cjlawson02/Rumtime/hardware/cad/refs/dc-inlet-plug.md

# 12 V inlet: 5.5 × 2.1 mm screw-terminal female plug (rear panel)

**Source:** seller listing, bought on AliExpress 2026-06-18 from VooVoo Dropshipping Store ("5pairs DC 12V Female And Male Connectors 5.5x2.1mm"), order ref 8211994997574039. Not yet measured.

## From the listing (unverified)

| Item | Value | Note |
| --- | ---: | --- |
| Barrel | 5.5 mm OD, 2.1 mm pin | Mates the GST60A12-P1J plug. The GST120A12-R7B has a DIN-4 plug and would need a 5.5 × 2.1 male fitted |
| Body | about 41 × 14 mm (1.6" × 0.55") | Listing height "5 in" is a typo |
| Wire entry | Screw terminals, no crimp | |
| Rating | 12 V DC, **2 A max** | Below the 5 A (GST60) and 10 A (GST120) fuses |

## Mounting

- No panel flange. The female plug sits in a printed holder set into the drawer face, socket flush with the outside. The holder clamps the body so pulling the PSU plug doesn't load the screw terminals.
- Builder choice (2026-11-01): use it as the PSU intake despite the 2 A listing. It must pass the heat test in Test 11.7 ([`14-bench-test-protocol.md`](../../../docs/14-bench-test-protocol.md)). If it fails, cut the PSU plug and hardwire the lead into J1 through a strain relief.
