cjlawson02/Rumtime/docs/15-project-timeline.md

# Project Timeline

Living Gantt and procurement log for Rumtime v1. Update after bench sessions, orders, and phase gates.

Reference: [`09-build-plan-and-verification.md`](09-build-plan-and-verification.md), [`14-bench-test-protocol.md`](14-bench-test-protocol.md).

**Last updated:** 2026-11-01 (KF301 + 1×22 in; Oct 25 motherboard batch complete; Oct 29 remainder + PCBs still out).

## Gantt chart

```mermaid
gantt
    title Rumtime v1 — build timeline
    dateFormat YYYY-MM-DD
    axisFormat %b %d

    section Planning
    Docs and v1 decisions           :done, plan, 2026-06-17, 3d
    Phase 0 mini-BOM and bench spec :done, bom, 2026-06-17, 1d
    Bench-rig CI workflow           :done, ci, 2026-06-20, 1d

    section Procurement
    Phase 0 bulk order placed      :done, po, 2026-06-18, 1d
    Phase 0 bulk parts received    :done, recv, 2026-06-27, 1d
    Load cell and HX711 ordered     :done, lc_po, 2026-06-23, 1d
    Load cell and HX711 received    :done, lc_recv, 2026-06-23, 14d
    Pump replacements              :done, pump_returns, 2026-06-27, 22d
    Barb replacement               :active, barb_return, 2026-06-27, 22d
    Load-cell bar measured + FDM   :done, lc_cad, 2026-08-16, 2d
    Cantilever assembled           :active, lc_asm, 2026-08-16, 1d

    section Bench electronics
    Firmware flash and serial       :done, fw, 2026-06-27, 1d
    TB6612 wired                    :done, wire, 2026-06-27, 1d
    HX711 and load cell bar wired   :lc_wire, after lc_recv, 1d
    P1 spin and stop command        :done, p1e, 2026-06-27, 1d
    P2 motor bus wired              :done, p2e, 2026-06-27, 1d

    section Bench liquid Phase 1
    Test 1 electrical baseline      :active, t1, 2026-06-27, 14d
    Test 2 prime and leak           :done, t2, 2026-06-27, 1d
    Test 3 flow calibration         :done, t3, 2026-06-27, 1d
    Test 4 pour repeatability       :active, t4, 2026-06-27, 14d
    Test 5 anti-drip tuning         :done, t5, 2026-06-27, 1d
    Fuse and main power cutoff install    :active, safe, 2026-06-27, 14d
    Test 6 syrup and grenadine      :t6, 2026-07-11, 7d
    Tests 7 to 9 load cell gating   :active, t79, 2026-08-16, 14d
    Test 10 I2C on first module     :t10, after p2fab, 7d
    Phase 0 to 1 pour review        :milestone, crit, p01exit, 2026-08-01, 1d

    section Phase 2 plus
    KiCad 4-pump schematic v1      :done, p2sch, 2026-08-16, 1d
    KiCad 4-pump layout            :done, p2des, 2026-08-16, 70d
    4-pump PCB ordered             :done, p2po, 2026-10-25, 1d
    4-pump module parts ordered    :done, p2parts, 2026-10-25, 1d
    Motherboard Mini560 + Micro-Fit verticals :done, mbparts, 2026-10-25, 1d
    Remaining electronics ordered  :done, mbparts2, 2026-10-29, 1d
    Main-controller PCB ordered    :done, mbpo, 2026-10-29, 1d
    Partial AliExpress receive     :done, ae_recv1, 2026-11-01, 1d
    JST-XH pigtails on all 8 motors :done, jst8, 2026-11-01, 1d
    4-pump PCB fab and assembly    :active, p2fab, after p2po, 21d
    Main-controller fab            :active, mbfab, after mbpo, 21d
    Cartridge and nozzle prototype  :p3, after p2fab, 21d
    8-pump v1 assembly              :p4, after p3, 30d
```

**Legend:** `done` = verified in repo or bench log; `active` = started, not complete; unmarked future bars = planned (dates are estimates until Phase 1 exit).

## Milestones

| Date | Milestone | Evidence |
| --- | --- | --- |
| 2026-06-17 | Project repo and v1 hardware docs | Initial commit |
| 2026-06-17 | Phase 0 decisions locked (KPHM100, TB6612, S3) | `12-phase-0-decisions.md` |
| 2026-06-17 | Bench-rig firmware tree added | `firmware/bench-rig/` |
| 2026-06-18 | Phase 0 bulk parts ordered (mini-BOM) | Operator |
| 2026-06-20 | Bench-rig CI (PlatformIO build) | `.github/workflows/` |
| 2026-06-23 | Load cell bar + HX711 ordered (same shipment)  | Operator |
| 2026-06-27 | Phase 0 bulk parts received (scale kit pending) | Operator |
| 2026-06-27 | Session 01 — TB6612 + P1 bring-up (no scale yet) | `bench-results/2026-06-27-session-01.md` |
| 2026-06-27 | Session 02 — P1+P2 @ 1.75 ml/s, anti-drip 100 ms | `bench-results/2026-06-27-session-02.md` |
| 2026-06-27 | 2× 24 V pumps returned; smooth couplers return **pending** (1.8 mm ID, on hand) | Operator |
| 2026-07-12 | Session 03 — product FW/kiosk pour (open-loop), cancel, Wi‑Fi disconnect stop | `bench-results/2026-07-12-session-03.md` |
| 2026-07-12 | Session 04 — HX711 MCU wired (GPIO 8/9); load cell bar pending | `bench-results/2026-07-12-session-04.md` |
| 2026-07-18 | 8× correct 12 V HB pumps on hand; 2× wrong 24 V pumps returned | Operator |
| 2026-07-19 | Session 05 — four-pump CAD coupons: mount holes pass; walls→2 mm; Ø32/Ø3.3; clamp silicone pending | `bench-results/2026-07-19-session-05.md` |
| 2026-08-16 | Session 06 — load-cell bar measured (75 mm, M4 tapped); bench cleat/pad/pins printing | `bench-results/2026-08-16-session-06.md` |
| 2026-08-16 | Session 07 — cantilever assembled (not measured); 4-pump schematic v1 ERC-clean; PCB silkscreen in progress | `bench-results/2026-08-16-session-07.md` |
| 2026-08-20 | Session 08 — load cell soldered + `scalecal 374.76`; Test 7.1 pass; Tests 7.2–9 deferred | `bench-results/2026-08-20-session-08.md` |
| later | Tests 7.2–9 (glass / vibration / flow-gate) | Deferred 2026-08-20 — **not** a 4-pump PCB gate |
| 2026-10-25 | 4-pump module PCB ordered (OSH Park, 3 boards) | Operator |
| 2026-10-25 | 4-pump module parts ordered (AliExpress equivalents) | Operator |
| 2026-10-25 | Motherboard + module AliExpress batch (Mini560, Micro-Fit V/RA, F1, terminals, passives) | Operator |
| 2026-10-29 | Remaining electronics: 1×8 sockets, Micro-Fit F–F harness, USB-C 6P, SS14, LEDs, 300 Ω | Operator |
| 2026-10-29 | Main-controller PCB ordered for fab | Operator |
| 2026-11-01 | Partial AliExpress receive: Micro-Fit RA 2×3, F1 1812-2A, JST-XH ×2 sets, MCP23017, Mini560 ×2, Micro-Fit vertical 6-pin | Operator |
| 2026-11-01 | More AliExpress: 0805 **2.2 kΩ**, 0805 **100 nF**, 0805 **10 kΩ**, KF301-5.0-2P ×10, plain female **1×22** / **1×6** / **1×4** / **1×8** | Operator |
| 2026-11-01 | JST-XH 2-pin female pigtails spliced/wired on **all 8** KPHM100 motors | Operator |
| 2026-11-01 | Enclosure layout draft accepted (four-slot rear tower, open back, Fire HD 8 pivot mount) | [`08-mechanical-design.md`](08-mechanical-design.md) layout + slot contract; `hardware/cad/src/enclosure_rear_bay_concept.py` |
| TBD | Test 10 (I2C on first module) | Post-fab bring-up — **not** a Gerber gate |
| TBD | Test 11 (enclosure draft checks) → cut wood | Gates "Cartridge and nozzle prototype" |
| TBD | First drink from 8-pump v1 | Phase 4 exit |

## Bench session log (timeline)

| Date | Session | Focus |
| --- | --- | ----- |
| 2026-06-27 | 01 | Firmware, TB6612, P1 dry spin (scale not wired) |
| 2026-06-27 | 02 | Water prime, flow cal, P2, anti-drip, Test 4b partial |
| 2026-07-12 | 03 | Product controller + kiosk: open-loop pour, cancel, disconnect stop (no scale) |
| 2026-07-12 | 04 | HX711 ↔ ESP32 (3.3 V / GND / DT=8 / SCK=9); load cell bar not soldered |
| 2026-07-19 | 05 | Four-pump CAD coupons: mount pattern pass; thin walls + Ø32/Ø3.3; clamp silicone pending |
| 2026-08-16 | 06 | Load-cell bar calipers (75×12.75, holes 5/15/59/69, M4 tap); cleat/pad/pins FDM |
| 2026-08-16 | 07 | Cantilever assembled (not measured); schematic v1 ERC-clean; PCB silkscreen |

## Procurement log

Fill **ordered** and **received** as you go. Sourced from [`13-phase-0-mini-bom.md`](13-phase-0-mini-bom.md).

| Item | Qty ordered | Received | Status | Notes |
| ---- | ---: | --- | --- | ----- |
| KPHM100-HB-B10 pump (12 V) | 10 cumulative | 2026-07-18 | **8 on hand / 2 returned** | The **8 on hand** are correct 12 V HB units. Seller previously shipped **2× 24 V** variants; both were returned. Only **P1+P2** have been bench-validated so far. |
| Pololu TB6612FNG #713 | 4 | 2026-06-27 | OK | **1** on bench (P1+P2); **3** spare — enough for 4-pump bench / Test 10 without reorder |
| ESP32-S3-DevKitC-1 | 1 | 2026-06-27 | OK | N16R8 on bench; 8 MB flash profile |
| Mean Well GST60A12-P1J (12 V 5 A) | 1 | 2026-06-27 | OK | Interim: bench DC supply also in use |
| 3×5 mm FDA silicone tubing | 2 rolls × 5 m | 2026-06-27 | OK | **10 m** total; 3×5 mm class (caliper waived — fit OK on bench) |
| PP barb unions (Quickun B08L5DTRCK class) | 1 set | 2026-06-27 | **Wrong SKU — return pending** | Shipped as **smooth silicone couplers** (slip join, not barbed). **Not yet returned** (post office pending). Operator measured **1.8 mm ID** bore vs **3 mm** line tubing. **Not** a barb union; on outlet (tube in one end, pour from other) narrows orifice vs open 3 mm tube. Food-contact rating not verified. Sessions 01–02 used **open ~3 mm outlet** (no restriction at tip). |
| Spring clamps | 1 set | 2026-06-27 | OK | |
| Inline fuse + main power cutoff | 1 | 2026-06-27 | OK | Not installed yet |
| Estardyn 5 kg load cell bar + HX711 | 1 set | on hand | **OK (cal)** | Session 08: soldered, `scale_ready`, **`scalecal 374.76`**. Test 7.1 pass; 7.2–9 deferred. |
| Graduated cylinder (250 ml) | 1 | 2026-06-27 | OK | In use session 02 |
| Breadboard + jumpers | 1 | 2026-06-27 | OK | |
| MCP23017 breakout | 1 | — | **skip** | Not buying. Test 10 is first assembled module (2026-08-20). |
| 4-pump module parts | 1 set | **2026-11-01** | **OK (parts)** | **On hand:** MCP23017-E/SO; Micro-Fit RA 2×3 (`43045-0600` class); F1 1812-2A; **both** JST-XH 2-pin 5-sets; 0805 **10 kΩ**; 0805 **100 nF**; plain female **1×8** sockets. **Harness:** female JST-XH pigtails wired on **all 8** motors (2026-11-01). Module PCB still out (OSH Park). |
| Motherboard power / bus / sockets | see notes | **2026-11-01** | **OK** | Mini560 **5 V** ×2; Micro-Fit vertical 6-pin; KF301-5.0-2P ×10; 0805 **2.2 kΩ**; plain female **1×22** / **1×6** / **1×4** (DevKit + HX711). |
| Motherboard remainder + harness | see notes | — | **ordered 2026-10-29** | Still out: USB-C **6P** top-mount class; **SS14** Schottky; 3 mm LED kit; **300 Ω** 0805 (LED_STATUS); Micro-Fit **43025** housings + **pre-crimped F–F leads** (DIY home-runs for ~3 modules). |

**Order dates:** Bulk mini-BOM **2026-06-18** (delivered **2026-06-27**). Load cell bar + HX711 **2026-06-23** — soldered and calibrated **2026-08-20** (`scalecal 374.76`). Module + motherboard AliExpress **2026-10-25** and **2026-10-29** — Oct 25 batches **complete 2026-11-01**; still out: Oct 29 harness/USB-C/LED parts, both PCBs.

### Recorded line prices (2026-11-08)

Operator-dictated line prices only. No grand total.

| Source | Item | Qty | Price (USD) |
| --- | ---- | --- | ---: |
| OSH Park | 4-pump module PCB | 3 boards | $13.65 |
| OSH Park | Main-controller PCB | 3 boards | $30.35 |
| AliExpress | 1×8 pin header | 10 pcs (paid total) | $1.86 |
| AliExpress | 0805 300 Ω resistors | — | $1.40 |
| AliExpress | JST 4-pin (XH) | — | $2.60 |
| AliExpress | Green LEDs | — | $1.36 |
| AliExpress | Red LEDs | — | $1.33 |
| AliExpress | Micro-Fit connector housings | — | $5.21 |
| AliExpress | Micro-Fit pre-crimped | — | $9.76 |
| AliExpress | USB-C jacks | — | $1.72 |
| AliExpress | Schottky diodes | — | $1.66 |
| AliExpress | Mini560 | 2 ($1.38 each; paid total after coupon) | $1.97 |
| AliExpress | 2-pin terminal blocks | — | $1.26 |
| AliExpress | Male header pin through-hole Micro-Fit (vertical, not right-angle) | — | $3.31 |
| AliExpress | 1812 2 A fuse | — | $1.14 |
| AliExpress | 0805 2.2 kΩ | — | $0.93 |
| AliExpress | 0805 10 kΩ | — | $1.43 |
| AliExpress | Right-angle Micro-Fit | — | $4.19 |
| AliExpress | 2-pin JST-XH | — | $3.48 |
| AliExpress | MCP23017-E SO | — | $6.33 |
| AliExpress | 0805 100 nF capacitor | — | $0.99 |
| AliExpress | Motors (2026-07-04 order) | 6 (paid total) | $64.98 |
| AliExpress | Motors (2026-06-18 order) | 4 ordered, 2 retained (net after refund; see note) | $23.77 |
| AliExpress | 12 V DC female and male barrel connectors | — | $2.37 |
| AliExpress | On-off switches | 5 pcs | $2.97 |
| AliExpress | Silicon cable, 12 AWG | 2 m | $5.44 |
| AliExpress | Unions | — (**excluded** — full refund; see note) | $4.59 |
| AliExpress | Silicon tubing | 10 m (paid total) | $12.21 |
| AliExpress | M5 tube clamps | — | $1.62 |
| Amazon (2026-06-18) | Inline fuse holders | 4-pack | $7.59 |
| Amazon (2026-06-18) | Mean Well GST60A12 power supply | — | $18.96 |
| AliExpress (2026-06-23) | Estardyn load cell + HX711 | — | $2.16 |
| AliExpress (2026-06-18) | ESP32-S3-DevKitC-1 N16R8 | 1 | $0.95 |
| AliExpress (2026-06-18) | Snvi TB6612FNG | 4 (paid total, incl. shipping) | $9.00 |
| AliExpress | 1×6 female sockets | 10 pcs | $1.33 |
| AliExpress | 1×4 female sockets | 10 pcs | $1.45 |
| AliExpress | 1×22 female sockets | 10 pcs | $2.07 |

**Note (4-motor / Jun 18 line):** Paid **$54.52** for 4; 2 returned (wrong units) with **$30.75** refund. **Net in running total: $23.77** for the 2 retained motors (`$54.52 − $30.75`). Jul 4 six-pack remains **$64.98**.

**Note (1×6 / 1×4 / 1×22 sockets group):** group total **$3.46** (subtotal **$4.85** minus coupon **$0.57** and bonus **$1.20**; ignore / disregard any **$0.38** additional charge).

**Note (unions):** Fully refunded (**$4.59**). **Excluded from running total** (same as canceled LCSC fuse).

Related earlier AliExpress line (Jun 18): SW1 round rocker 5 pcs **$2.97** — see [`hardware/cad/refs/sw1-round-rocker.md`](../hardware/cad/refs/sw1-round-rocker.md). Same figure as the on-off switches row above.

### Open replacements

| Item | Need | Action |
| ---- | ---- | --- |
| Smooth silicone couplers (wrong SKU) | 1 set | **Return pending** — post office not yet; Amazon return for barb-union mis-ship |
| **Barbed** 1/8" PP unions (3×5 mm line) | 1 set | **Deferred** — re-order when plumbing mid-line joins; AliExpress 3 mm PE barbs (Jun 18) were full-refunded |
| M4 × 16–20 mm screws (load cell) | handful | Optional later — bench uses printed taper pins; metal M4 not on hand |

### Still not ordered

| Item | Notes |
| ---- | ----- |
| GST120A12-R7B | Phase 4 / 8-pump PSU — not needed for first module |
| Barbed unions | **Deferred** (see open replacements) |
| Logic-level N-MOSFET (ring light) | **Open (2026-11-08):** verify whether a suitable logic-level N-channel MOSFET is already on hand to switch the hood **12 V ALLCOBLED COB ring** from a free DevKit GPIO (+ external low-side switch). If not on hand, order one (TO-220 or SOT-23). Do **not** reuse `LED_STATUS` / GPIO 38; see [`12-phase-0-decisions.md`](12-phase-0-decisions.md) 2026-11-08 rev-2 note. |

### Future orders (not Phase 0)

| Item | Target phase | Ordered | Received |
| ---- | --- | --- | --- |
| 4-pump KiCad module PCB | 2 | 2026-10-25 (OSH Park, 3) | — |
| 4-pump module parts (+ F1, 1×8) | 2 | 2026-10-25 / 29 (AliExpress) | **2026-11-01** (all stuffing parts on hand; PCB separate) |
| Mini560 + Micro-Fit vertical + KF301 + sockets | 5 (motherboard) | 2026-10-25 (AliExpress) | **2026-11-01** |
| USB-C, SS14, LEDs, 300 Ω, Micro-Fit harness | 5 (motherboard) | 2026-10-29 (AliExpress) | — |
| Main-controller PCB | 5 | 2026-10-29 | — |
| GST120A12-R7B (8-pump PSU) | 4 | — | — |
| Barbed 1/8" PP unions | plumbing | **deferred** | — |
| Second 4-pump module set (beyond 3 PCBs) | 4 | — | — |

## How to update

1. After each bench session — add a row to **Bench session log**; shift or mark Gantt tasks `done` / `active`.
2. When you order or receive parts — fill **Procurement log** dates.
3. When a phase gate passes — add a **Milestones** row and adjust Phase 2+ bar start dates.
4. Optional — open the live canvas: [`rumtime-timeline.canvas.tsx`](/Users/chris2fourlaw/.cursor/projects/Volumes-Workspace-GitHub-Rumtime/canvases/rumtime-timeline.canvas.tsx) (mirrors this file; edit the markdown as source of truth).
