cjlawson02/Rumtime/docs/10-open-questions-and-v2.md

# Open Questions and V2 Ideas

## Open questions — software and firmware

1. HTTP/API contract shape (`/dispense`, `/config`, status transport) — deferred until firmware layers are stable; see [`16-firmware-and-software-architecture.md`](16-firmware-and-software-architecture.md).
2. Offline pour when internet is down but LAN works — deferred; options are kiosk recipe cache or ESP32 favorites snapshot. Kiosk UX locked in [`17-kiosk-ui-plan.md`](17-kiosk-ui-plan.md).
3. LAN authentication (PIN, pairing) — deferred; home-trusted LAN assumed for v1.
4. **OTA firmware updates (ESP32-S3) — Open (2026-11-08):** not implemented; updates are USB-serial only (default board flash profile, no custom partition map). Planned approach (inspired by ESPHome, not a copy of its native TCP protocol): dual-app partition layout (`app0`/`app1` + `otadata`, NVS preserved), Arduino or ESP-IDF OTA write APIs, idle-only authenticated HTTP upload on the existing device HTTP server, plus rollback confirmation and hardening. Effort: a few days for a prototype; about a week or two including rollback and hardening. Do not start until explicitly prioritized. See [`16-firmware-and-software-architecture.md`](16-firmware-and-software-architecture.md).

## Open questions before buying full BOM

1. ~~Which exact pump model gives the best cost/reliability/flow tradeoff?~~ **Resolved for Phase 0:** Kamoer **KPHM100-HBB10** — bench-verify samples. See [`12-phase-0-decisions.md`](12-phase-0-decisions.md).
2. What is the measured pump current under water, syrup, and startup/stall conditions? *(Rated 0.5 A; stall TBD on bench — use [`14-bench-test-protocol.md`](14-bench-test-protocol.md).)*
3. ~~What tubing size is actually compatible with the chosen pump head?~~ **Resolved:** BPT B10, **3 mm ID × 5 mm OD**.
4. ~~Are cheap quick disconnects acceptable, or are barbs/clamps better for v1?~~ **Resolved for Phase 0–1:** barbs + clamps; selective QD later.
5. Does anti-drip reverse work without de-priming the line? *(Bench Tests 5, 4b, 9; flow-gated pour start mitigates under-pour when line fill varies.)*
6. Does the load cell remain stable enough for **flow-gated dispense** with glass plus ice during pump vibration? *(**Deferred 2026-08-20** — Tests 7.6, 9 later; bar cal done. Still gates proven v1 default vs timed fallback when we run them.)*
11. What `flow_threshold` and timeout work across water, syrup, and simultaneous 2-pump pours?
12. Is **8-pump simultaneous** pour into one glass acceptable for splash/overflow? *(Not testable on 2-pump bench — Phase 4.)*
13. Does **GST120** handle 8-pump inrush without sag that breaks calibration? *(Simulate on bench with measured currents.)*
7. ~~What enclosure dimensions are needed after real pump/cartridge measurements?~~ **Layout decided (draft, 2026-11-01):** four-slot rear tower with pump heads out the back, open glass bay, electronics box under slot A, Fire HD 8 pivot mount. Draft size 284 × 266 × 409 mm. Wood dimensions stay open until the cartridge slide-in and nozzle-ring checks in [`08-mechanical-design.md`](08-mechanical-design.md) pass.
8. How much residue remains after syrup/grenadine/citrus cleaning tests?
9. ~~Is 8 pumps enough for the desired drink menu, or should the enclosure start with 12 physical nozzle positions?~~ **Resolved:** Start with **8 installed pumps**; design enclosure and electronics for **16 pumps max** (four 4-pump module slots). MCP23017 addressing allows more; 16 remains the mechanical/power ceiling. Pre-plan physical space for 16 inlet clips and nozzles; populate only 8 at first build.
10. ~~How should pump/bottle labels be handled so setup is obvious?~~ **Resolved:** **Dual labels** — label on each **rear inlet-comb clip** (no inlet panel since the 2026-11-01 open-back layout); matching label on each **bottle stopper** where the pickup tube enters. Tube color optional later.

## V2 ideas

Do not implement these until v1 works.

### Mini fridge integration

Possible goal:

- Keep fresh juices chilled while connected.

Concerns:

- Safe tube pass-through.
- Condensation.
- Cleaning.
- Bottle organization.
- Fridge drilling risk.

Recommended approach:

- Avoid drilling unless safe path is known.
- Use existing drain/gasket/pass-through if possible.
- Treat fridge integration as a separate design project.

### Carbonated mixer support

Possible goal:

- Pump or dispense soda/tonic/cola automatically.

Concerns:

- Foam.
- Loss of carbonation.
- Cleaning sticky soda lines.
- Need for chilled storage.
- Different flow behavior than still liquids.

Recommended approach:

- Keep manual top-off in v1.
- Later test one dedicated carbonated line before expanding.

### Bottle-level sensing

Possible goal:

- Detect actual bottle contents instead of estimating inventory.

Options:

- Bottle scales.
- Float/level sensors.
- Vision/manual barcode workflows.
- More careful inventory reconciliation using glass load-cell data.

V1 decision: use software-estimated inventory.

### More accurate closed-loop pouring

Possible goal:

- Sequentially pour each ingredient until target mass is reached.

Concerns:

- Slower.
- Needs density assumptions or per-ingredient density.
- Needs stable load-cell readings during pump vibration.

Recommended path:

1. Use load cell for calibration and **flow-gated timer start** (v1).
2. Use load cell for final sanity check.
3. Add sequential scale-assisted **mass stop** per ingredient only if timed + flow-gate is not good enough.

### Better module network

Possible goal:

- Robust long cable runs and smart modules.

Options:

- CAN bus.
- RS-485.
- Small MCU per module.

V1 decision: I2C is acceptable for short runs under about 3 ft.

### Premium fittings

Possible goal:

- Cleaner ingredient swaps and less mess.

Options:

- Valved CPC/Colder-style quick disconnects.
- Panel-mounted bulkhead quick disconnects.
- Labeled bottle harnesses.

V1 decision: use these selectively because cost multiplies quickly across 8-12 lines.

## Known risks

| Risk | Mitigation |
| --- | --- |
| Cheap pumps vary in flow rate | Calibrate each pump and keep spares. |
| Tubing wears and flow drifts | Treat tubing as consumable; recalibrate periodically. |
| Syrup dries in nozzles | Use warm-water flush and removable nozzle plate. |
| Citrus/juice sanitation issues | Use session-only handling and clean after use. |
| I2C noise with motors | Keep cables short, use proper grounding, add decoupling, lower I2C speed. |
| Pump startup current exceeds driver | Measure current before final PCB; choose driver accordingly. |
| Liquid leaks into electronics | Separate wet/dry compartments; leak test with water. |
| Reverse pump de-primes line | Tune anti-drip; **flow-gated dispense** for recipe pours. |
| Variable line fill breaks timed pour  | Flow-gate on load cell; drip-tray prime stays timed + visual. |
| Bench GPIO ≠ production I2C path | First module PCB is Test 10 (2026-08-20); accept a spin. |
| 8-pump simultaneous untested on bench | Phase 4 recipe simulation; accept incremental risk at PCB fab. |
| Inventory estimate drifts | Use low-volume reserve and manual refill confirmations. |
| Project overcomplicates | Follow AGENTS.md: simplicity first and goal-driven verification. |
