cjlawson02/Rumtime/docs/01-decisions.md

# Captured Design Decisions

This file is the source of truth for current hardware decisions.

## Project identity

| Topic | Decision |
| --- | --- |
| Project name | Rumtime. |
| Short description | A modular cocktail execution engine. |
| Tagline | Compile recipes. Execute cocktails. |
| Repo name | `rumtime`. |
| Naming style | Software-engineer humor is encouraged in docs and module names when it improves clarity, but hardware docs should stay precise. |

Rationale: Rumtime is short, memorable, software-themed, and still clearly connected to drinks. It supports playful terminology without forcing unclear puns into safety-critical hardware documentation.

## Pump count

| Topic | Decision |
| --- | --- |
| V1 pump count | Build for **8 installed pumps**.  |
| Acceptable starting range | 6-8 pumps. |
| Expansion target | 10-12 pumps in near term. |
| **Design limit** | **16 pumps** (4× 4-pump modules). |
| Expansion unit | 4-pump module. |

Rationale: 8 pumps supports useful cocktails without making the first build too large. Designing around 4-pump modules allows expansion without changing controller architecture. **16 pumps is the v1 mechanical/power ceiling** (four module slots). I2C addressing is not the limiter (MCP23017 has eight addresses). Beyond 16 would still need enclosure, PSU, and nozzle-cluster work — not a bus mux.

## Pump strategy

| Topic | Decision |
| --- | --- |
| Pump type | Peristaltic pump. |
| Pump assignment | One pump per ingredient. |
| Reverse pumping | Required if reasonably affordable. |
| Solenoids | Avoid for v1. |
| Shared manifold | Avoid. |
| Phase 0 model | **Kamoer KPHM100-HB-B10** (12 V brushed, B10 3×5 mm tubing). |
| Phase 0 qty | 3 pumps (2 rig + 1 spare). Bench-verify before full BOM. |

Rationale: One pump per ingredient avoids solenoid complexity, cross-contamination, shared-path cleaning, and priming problems. Reversible pumps support anti-drip behavior, draining, and cleaning. KPHM100-HBB10 matches flow, cost, tubing, and TB6612 current targets; see [`12-phase-0-decisions.md`](12-phase-0-decisions.md).

## Measurement strategy

| Topic | Decision |
| --- | --- |
| Primary measurement | Timed dispensing based on calibrated `ml_per_second`. |
| Pour timing | **Flow-gated start** when glass on load cell; timed-from-motor-on fallback on scale fault. |
| Priming requirement | Session prime over drip tray; recipe pours tolerate variable line fill via flow-gating. |
| Flow sensors | Avoid inline flow meters in v1. |
| Load cell | **Required** (5 kg + HX711 under glass). |
| Accuracy target | Good enough, not laboratory precise. |
| Deferred | Per-ingredient closed-loop mass stop during simultaneous 8-pump pours. |

Rationale: Timed dispensing is simple and cheap. Variable line fill after anti-drip makes motor-on timers wrong; flow-gating uses the load cell already required for glass/ice detection. Vibration/flow-gate proof is Test 9 — **deferred 2026-08-20** after bar cal (session 08); not cancelled.

## Glass and dispense position

| Topic | Decision |
| --- | --- |
| Glass location | One fixed dispense location. |
| Ice before pour | Yes, user may place ice in glass first. |
| Glass detection | **Required** — load cell under glass platform. |
| Recommended sensor | Load cell serves glass, ice tare, flow-gate, sanity checks. |

## Ingredients

| Ingredient type | Decision |
| --- | --- |
| Spirits | Support. |
| Liqueurs | Support. |
| Simple syrup | Support; flush after session. |
| Grenadine | Support; flush after session. |
| Fresh citrus, no pulp | Session-only; flush after use. |
| Non-pulpy juices | Support as session-only or refrigerated later. |
| Pulpy juices | Skip in v1. |
| Cream/coconut/purées  | Skip in v1. |
| Carbonated mixers | Manual top-off in v1. |

Rationale: Sugary, acidic, and fresh ingredients are manageable if flushed. Pulp and thick dairy/coconut-style ingredients increase clogging and sanitation risk.

## Carbonation

| Topic | Decision |
| --- | --- |
| Pump carbonated mixers | Not in v1. |
| UI behavior | Recipe can say "top with soda/tonic/cola/etc." |
| Possible v2 | Dedicated chilled/carbonated line can be explored later. |

Rationale: Carbonated liquids foam, lose carbonation, and complicate cleaning. Manual top-off gives most of the value with little complexity.

## Bottles and storage

| Topic | Decision |
| --- | --- |
| Bottle location | External to machine. |
| Bottle size | Flexible; support common 750 ml and 1 L bottles via configuration. |
| Pickup style | **Bottle stoppers** with labeled pickup tubes (not bare dropped-in tubes for v1). |
| Bottle caps/adapters | **Labeled stoppers** per bottle; match machine inlet labels. |
| Fresh juices | Connect only during use unless fridge integration is designed later. |
| Mini fridge | Defer. Do not drill/plumb in v1. |

## Cleaning

| Topic | Decision |
| --- | --- |
| Cleaning effort | Moderate is acceptable. |
| Rinse/flush | Required. |
| Sanitizer | Star San or similar session sanitizer may be used. |
| Permanent sanitizer tank | Not recommended in v1. |
| Tubing | Replaceable consumable. |
| Quick disconnects | Preferred where budget allows. |
| Session-only ingredients | Acceptable. |

## Modular hardware

| Topic | Decision |
| --- | --- |
| Module style | 4-pump expansion boards. |
| Module cases | 3D printed clean cartridges/cases preferred. |
| Distance | Under 3 ft from main controller. |
| Hot-swap | Mechanically swappable, but not powered hot-swap. |
| Connectors | Cheap/easy is acceptable if rigid and reliable. |
| Design style | Cheap and practical, visually clean. |

## Electronics

| Topic | Decision |
| --- | --- |
| Main controller | ESP32, recommended ESP32-S3. |
| Network | Wi-Fi only. |
| Pump voltage | 12 V recommended by default. |
| Pump control | On/off + reverse via I2C GPIO expander; TB6612 PWM strapped high. Speed PWM deferred. |
| I/O expander | **MCP23017-E/SO** per 4-pump module (backup: TCA9539PWR). PCA9685 rejected. |
| Physical controls | Bare minimum. |
| Safety cutoff | Include **main power** cutoff/emergency stop (no separate pump-bus switch). |
| Custom PCB | Expected and acceptable. |
| PCB toolchain | **KiCad 10** (`kicad-cli`) for 4-pump module and future boards. |
| Phase 0 electronics | TB6612FNG breakout + ESP32-S3-DevKitC-1 on breadboard. Bench carrier is Pololu #713. |
| Module driver | AliExpress **SparkFun-pinout** TB6612 clone (item `3256807799494692`), two per 4-pump module. Rows **15.25 mm**, body **21 × 18 mm**. Pololu #713 stays on the bench. |

## Mechanical design

| Topic | Decision |
| --- | --- |
| Appearance | More finished than a raw maker prototype. |
| CAD | **Onshape** for mechanical models; export STEP/STL for print and bench fixtures.  |
| Fabrication | **FDM 3D printer** on hand; woodworking preferred for visible enclosure. |
| Footprint | No hard limit, excluding bottles. |
| Portability | Not required. |
| Bottle visibility | Bottles separate from machine. |
| Labeling | Label on each **rear inlet-comb clip**; matching label on **bottle stopper**. |
| Drip tray | Required. |
| Nozzle style | Individual clustered nozzles; removable funnel acceptable if easy to clean. |

## Budget

| Topic | Decision |
| --- | --- |
| V1 budget target | About $500 max, excluding ingredients. |
| Pump quality | Willing to pay more for reliability if value is clear. |
| Sourcing | Check McMaster for cheap/appropriate food-contact tubing/fittings, but avoid overbuying premium industrial parts. |
| Priority | Best bang for buck. |

## Software stack

| Topic | Decision |
| --- | --- |
| Kiosk UI | Static **React** PWA on **Cloudflare Pages** — see [`17-kiosk-ui-plan.md`](17-kiosk-ui-plan.md). |
| Kiosk frontend | **React 18 + Vite + Tailwind v4 + shadcn** (`base-nova` / Base UI). Production app in [`ui/kiosk/`](../ui/kiosk/). |
| Kiosk device | **Kindle Fire** (Fully Kiosk browser). |
| Real-time control  | **ESP32-S3** product firmware on LAN. |
| Kiosk ↔ ESP32 link | **Wi-Fi HTTP** (JSON). BLE deferred. |
| Wi-Fi (v1) | **Station mode** on home LAN only; credentials via **serial** until soft-AP provisioning. |
| Device discovery | **mDNS** (e.g. `rumtime.local`); DHCP reservation fallback. |
| Pour path | Kiosk → ESP32 directly; **not** through Cloudflare. |
| Kiosk UX | Locked in [`17-kiosk-ui-plan.md`](17-kiosk-ui-plan.md) (menu grid, PIN, bottle bay, pour tuning, session confirm, pour anyway). |
| Recipe content | **Bundled JSON** in kiosk repo for v1 (`src/data/recipes.json`); Cloud KV optional later. Recipes use **ingredient IDs**, not pump numbers. |
| Ingredient IDs | **Opaque strings on ESP32** (binding + dispense lookup). Names/categories/recipes are **kiosk-only**. |
| Pump ↔ ingredient  | **ESP32 NVS** (machine owns what is plumbed). |
| Inventory | **ESP32 authoritative**; subtract on dispense; persists in NVS. |
| Offline operation  | **Bundled recipes + PWA cache** (v1); KV sync optional later. |
| API contract | **Implemented** — firmware exposes kiosk `DeviceStatus` shape per [`18-kiosk-device-api.md`](18-kiosk-device-api.md). |

Rationale: Physical reality (bindings, calibration, inventory) must survive reboot and match plumbed lines. Creative content (recipes) can update in the cloud without reflashing. LAN HTTP matches a browser kiosk and keeps dispense latency off the public internet.

## Firmware architecture

| Topic | Decision |
| --- | --- |
| Framework | **PlatformIO + Arduino** on ESP32-S3 (continue from bench-rig). |
| Runtime model | Explicit FreeRTOS — `ControlTask` + command queue + status snapshot. |
| Control pattern | Periodic **ControlTask** tick + thin **sequence runner** (FRC-inspired, not WPILib). |
| WPILib on ESP32 | No — port the pattern only. |
| Blocking dispense | Not in product firmware — bench rig blocking model is bring-up only. |
| Control period | **5 ms default** (1–10 ms); HX711 non-blocking FSM inside `ScalePlatform`. |
| Concurrency | **0 mutexes on motion path**; queue + snapshot at HTTP boundary. |
| Software mode enum | **Not required v1** — main power cutoff is hardware disable. |
| Manual pours | **Always available in software**; no rear-panel test jumper. |
| Job concurrency | One coordinator job; command queue depth 1; **409 busy** on duplicate dispense. |
| Pump exclusivity | Coordinator policy; `PumpChannel` refuses overlap via bus policy. |
| Pump safety (hardware) | **Main power cutoff** + TB6612 **STBY**; safe GPIO at boot. **No separate pump-bus switch. No bus MOSFET v1.** |
| Pump safety (software) | **Distributed** in pumps, scale, coordinator, steps — no central safety pipeline. |
| JSON on device | **ArduinoJson v7** (`WebServer` on Core 0). |

Full layer diagram and migration notes: [`16-firmware-and-software-architecture.md`](16-firmware-and-software-architecture.md).
