cjlawson02/Rumtime/docs/09-build-plan-and-verification.md

# Build Plan and Verification

This plan follows goal-driven execution: every step has a verification check.

**Bench progress (2026-08-20):** [session 08](bench-results/2026-08-20-session-08.md) — load cell **soldered and calibrated** (`scalecal 374.76`; Test 7.1 pass). Remaining Tests **7.2–7.6** / **9** **deferred** (operator). [Session 07](bench-results/2026-08-16-session-07.md) — cantilever printed/assembled. [Session 06](bench-results/2026-08-16-session-06.md) — bar **measured 75 × 12.75 mm**, holes **5 / 15 / 59 / 69**, **M4 tapped**. [Session 05](bench-results/2026-07-19-session-05.md) — four-pump CAD coupons: mount hole pattern **pass**; walls → **2 mm**; clearance **Ø32 / Ø3.3**; **clamp silicone snap still pending**. Session 03: product controller + kiosk pour / cancel / disconnect. Liquid cal: [session 02](bench-results/2026-06-27-session-02.md) — P1+P2 @ 1.75 ml/s; dual **~0.4 A**; anti-drip 100 ms; Test 4b P2 50→~45 ml.

## Phase 0: Confirm critical parts

1. Select candidate pump.
   - Verify: pump is reversible, 12 V, affordable, and physically measurable.
2. Select tubing and fitting size.
   - Verify: tubing fits pump and fittings without leaks or kinks.
3. Select motor driver.
   - Verify: measured pump current is within driver limits with margin. _(P1: I_run ~0.2 A dry/wet; I_stall_dry 0.9 A, I_stall_wet ~0.33 A — TB6612 OK.)_
4. Select power supply strategy.
   - Verify: supply can run expected simultaneous pumps with margin.

Exit criteria:

- One pump can move water forward and backward under controller or bench control. _(P1 pass — prime, cal, timed dispense.)_
- Tubing/fittings are physically compatible. _(3×5 mm tubing fits KPHM100 B10; caliper waived; barb-union order mis-shipped as 1.8 mm ID smooth couplers — return pending; barbed unions still to re-order.)_
- Pump current is known well enough for driver selection. _(P1 dry + wet documented.)_

## Phase 1: 2-4 pump liquid prototype

Build a temporary rig with 2-4 pumps.

1. Wire pumps to driver breakout or temporary PCB.
   - Verify: each pump runs forward, reverse, and stops reliably. _(P1 + P2 pass.)_
2. Prime lines from bottles/jars.
   - Verify: each line primes without leaks or collapsing tubing. _(P1 + P2 pass.)_
3. Dispense by time.
   - Verify: 15 ml, 30 ml, and 60 ml targets within tolerance after calibration. _(50 ml: P1 ~48, P2 ~50; 15/60 ml open.)_
   - Verify: 15 ml, 30 ml, and 60 ml test pours are repeatable enough.
4. Test anti-drip reverse.
   - Verify: nozzle drip is reduced without losing prime.
5. Test syrup and grenadine.
   - Verify: pump can dispense and flush them without obvious clogging.
6. Test warm-water flush.
   - Verify: visible residue clears from lines/nozzles.
7. Test load cell and flow-gating (v1 pour default; **not** a 4-pump PCB gate).
   - Verify: detects glass, glass plus ice, flow-gated vs timed pour (Tests 7–9).
8. Validate I2C pump path on the **first assembled module** (Test 10).
   - Verify: MCP23017 on the PCB drives pumps; bus stable under motor load. Not a pre-fab breakout.

Exit criteria (pour path; parallel with module schematic):

- At least two pumps pass repeatability tests.
- Syrup/grenadine can be flushed acceptably.
- Anti-drip reverse has a workable setting; Test 4b trend documented.
- Load cell Tests 7–9 pass or flow-gate fallback documented.
- No critical issue requires changing the architecture.

## Phase 2: First 4-pump module PCB

**Schematic v1:** ERC-clean (`hardware/kicad/scripts/check.sh`). HX711 is on the controller, not this board. Stall current already supports TB6612.

**Layout:** in progress (silkscreen / placement). **Fab prerequisite:** DRC + schematic safe-off (Test 10.4). I2C hardware bring-up is Test 10 on first article.

Design and fabricate one 4-pump module PCB.

1. Create schematic.
   - Verify: ERC passes and safe default pump-off behavior is reviewed. _(v1 ERC 0 — 2026-08-16.)_
2. Create layout.
   - Verify: DRC passes and motor current paths are sized appropriately. _(Silkscreen/placement in progress.)_
3. Confirm connectors.
   - Verify: connector pinouts match wiring harness plan.
4. Confirm mounting.
   - Verify: board holes align with a printed/measured cartridge mockup.
5. Assemble one board.
   - Verify: no shorts; logic power and 12 V rails test correctly.
6. Test with one pump.
   - Verify: forward/reverse/stop works.
7. Test with four pumps.
   - Verify: all channels work and simultaneous operation does not brown out/reset logic.

Exit criteria:

- One 4-pump module runs four pumps reliably.
- Module address selection works.
- Module can be physically mounted in a cartridge.

## Phase 3: Mechanical cartridge and nozzle prototype

1. Design 4-pump cartridge.
   - Verify: pumps mount securely and tubing can be serviced.
2. Design nozzle plate.
   - Verify: all outputs aim into the glass and plate is removable.
3. Design drip tray area.
   - Verify: drips fall into removable tray, not electronics.
4. Design tube inlet strain relief.
   - Verify: bottle tubes cannot tug directly on pump fittings.

Exit criteria:

- One cartridge can be installed/removed.
- Tubing can be routed without kinks.
- Nozzle plate and drip tray are cleanable.

## Phase 4: 8-pump v1 assembly

1. Build two 4-pump modules.
   - Verify: each module works independently.
2. Install modules into enclosure.
   - Verify: wet side and electronics are physically separated.
3. Connect 8 liquid paths.
   - Verify: no leaks during priming and flush.
4. Run full calibration.
   - Verify: every pump has stored ml/sec and passes target pour tests.
5. Run recipe simulation with water.
   - Verify: multiple pumps dispense into glass without missing target badly.
6. Run real ingredient session.
   - Verify: drinks are acceptable and cleanup is moderate.

Exit criteria:

- Machine can make a useful set of drinks with 8 ingredients.
- Cleaning workflow is acceptable enough to repeat.
- Inventory tracking can warn before low bottles.

## Phase 5: 12-pump expansion readiness

1. Install or mock third module slot.
   - Verify: physical space, power connector, and I2C address path exist.
2. Connect third module electrically without pumps.
   - Verify: system can detect/address the module.
3. Add pumps 9-12 later.
   - Verify: power supply and wiring can handle additional load.

Exit criteria:

- Expansion to 12 pumps does not require redesigning the enclosure, controller, or power distribution.

## Calibration test matrix

For each pump:

| Test | Target | Pass condition |
| --- | ---: | --- |
| Small pour | 15 ml | Good-enough repeatability. |
| Standard pour | 30 ml | Good-enough repeatability. |
| Large pour | 60 ml | Good-enough repeatability. |
| Anti-drip | Per pump | No excessive dripping; Test 4b without re-prime documented. |
| Flow-gate | Per recipe | Gated vs timed error on de-primed line (Test 9). |
| Flush | Per pump | No visible residue after cleaning cycle. |
| Reverse | Per pump | Pump reverses without leaks or tube collapse. |

Define numeric tolerances after initial prototype results. Do not over-optimize before measuring real pump behavior.

## Cleaning verification

After a real ingredient session:

1. Flush syrup line.
   - Verify: outlet runs clear and is not sticky at nozzle.
2. Flush grenadine line.
   - Verify: color mostly clears and no visible residue remains.
3. Flush citrus/juice line.
   - Verify: no visible residue or pulp remains.
4. Sanitize per label.
   - Verify: contact time and drain/purge steps are completed.
5. Inspect next day.
   - Verify: no obvious odor, residue, or sticky nozzle.

## Safety verification

Before using with ingredients:

1. Activate **main power** cutoff during pump operation.
   - Verify: pumps stop.
2. Reset ESP32 during operation.
   - Verify: pumps stop or remain off.
3. Disconnect/reconnect logic with pump power off.
   - Verify: no unexpected pump activation after reconnect.
4. Simulate no glass (load cell required).
   - Verify: dispensing is blocked or warning is shown.
5. Flow-gated pour with de-primed line.
   - Verify: gated pour within tolerance or fallback documented.
6. Leak test with water.
   - Verify: leaks do not reach electronics.

## Do not skip

- Pump current measurement.
- Tubing/fitting compatibility test.
- Syrup/grenadine cleaning test.
- Anti-drip reverse tuning.
- Load cell flow-gate validation (or documented fallback) — v1 pour default, not a module PCB gate.
- MCP23017 I2C bring-up on the first module PCB (Test 10; not a pre-fab breakout).
- Leak test with water before alcohol/sugar.
- Hardware **main power** cutoff.
