cjlawson02/Rumtime/docs/06-flow-calibration-and-inventory.md

# Flow Calibration and Inventory

This file describes measurement behavior. It is not a software implementation spec.

## Measurement decision

V1 uses **timed dispensing** based on per-pump calibration (`ml_per_second`), with a **load cell under the glass** for guardrails and **flow-gated pour start** when a glass is present.

Inline flow meters are intentionally skipped in v1 because they add cost, cleaning burden, extra wet parts, and possible problems with syrup, bubbles, and pulsed peristaltic flow.

## Accuracy target

The selected target is **good enough** cocktail accuracy, not laboratory accuracy.

A practical v1 goal:

- Repeat common pours within roughly 5-10 ml during normal timed operation.
- Improve calibration or add scale-assisted sequential pouring later if this is not acceptable.

## Calibration model

Each pump/ingredient gets a calibrated flow rate:

```text
ml_per_second = measured_output_ml / run_time_seconds
```

Use that value for dispensing:

```text
run_time_seconds = target_ml / ml_per_second
```

Calibration should be per pump and preferably per ingredient type, because syrup and spirits may flow differently.

## Basic calibration procedure

Manual measuring cup method:

1. Put pickup tube in ingredient or water.
2. Prime line until liquid reaches nozzle.
3. Run pump for a fixed duration, such as 20-30 seconds.
4. Measure output volume in a graduated cylinder or measuring cup.
5. Compute and store ml/sec.
6. Repeat once or twice and average if desired.

Load-cell method:

1. Put a cup on the load-cell platform.
2. Tare the scale.
3. Prime the line.
4. Run pump for a fixed duration.
5. Measure mass increase.
6. Convert mass to approximate ml.
7. Store ml/sec.

For many cocktail ingredients, using 1 g approximately equal to 1 ml is good enough for calibration. If better accuracy is needed, store density per ingredient later.

## Priming state

Timed dispensing from motor-on assumes the line is already full. In practice, fill level is **variable**: dry line, partially wet after anti-drip reverse, or full with a dry nozzle tip. Fixed-time “prime until nozzle wet” cannot know how much liquid is in the line without a sensor.

Track per pump:

```text
pump_id
primed true/false
last_primed_at
last_cleaned_at
```

Possible behavior:

- After cleaning or tube replacement, mark line unprimed.
- After a successful prime cycle (timed over drip tray, or flow detected at glass), mark line primed.
- Do not run normal recipes with an unprimed line unless the user confirms.
- **Flow-gated dispense** (below) reduces dependence on `primed` for recipe pours into a glass on the scale.

## Anti-drip reverse

After each pour, reverse briefly to reduce nozzle drip.

Track per pump:

```text
anti_drip_reverse_ms
```

Start with a conservative value and tune per liquid.

Too little reverse: dripping.
Too much reverse: line partially de-primes and next pour is low.

## Simultaneous versus sequential dispensing

### Normal mode: simultaneous timed pouring

Pros:

- Faster.
- Good for parties.
- Good enough when pumps are calibrated.

Cons:

- Scale cannot tell which ingredient under-poured.
- Total final mass only gives a sanity check.

### Precision mode: sequential scale-assisted pouring

Pros:

- More accurate.
- Can stop each ingredient based on weight increase.
- Easier to detect a problem with a specific line.

Cons:

- Slower.
- More software complexity.
- Requires stable glass platform and tare.

V1 recommendation:

- **Default:** timed simultaneous pours with **flow-gated timer start** when glass is on the load cell.
- **Fallback:** timed-from-motor-on if scale fault or no glass detected.
- **Defer:** fully closed-loop sequential pouring (stop each ingredient by target mass).

## Flow-gated simultaneous dispense

When a glass is on the platform (tared after ice if needed), recipe pours should **not** start ml timers at motor-on. Instead:

```text
1. Start recipe pumps forward (simultaneous mode).
2. Wait for d(weight)/dt > flow_threshold for N consecutive samples (global, one scale).
3. Start per-pump ml timers from that moment.
4. Run each pump for target_ml / ml_per_second.
5. Apply per-pump anti_drip_reverse_ms.
6. Compare total mass increase to expected; warn on large mismatch.
```

**Pre-gate timeout:** if no flow within `flow_detect_timeout_ms`, abort, mark suspect/unprimed, alert user.

**Limits (important):**

- One scale → **one global** flow-onset signal, not per-pump. If P1 is primed and P2 is dry, timers start when the first stream hits the glass; P2 may still under-pour until its line fills. Flow-gating fixes the common case (similar line state after anti-drip); it does not replace per-line priming for asymmetric failures.
- Requires mechanical isolation of the glass platform from pump vibration — see [`08-mechanical-design.md`](08-mechanical-design.md).
- Bench must validate thresholds before locking as v1 default — see Test 9 in [`14-bench-test-protocol.md`](14-bench-test-protocol.md). If vibration blocks reliable detection, fall back to timed dispense + post-pour sanity check; keep the load cell for glass/tare/no-flow.

Drip-tray priming (no glass) remains **timed + visual** “nozzle wet.”

## Load cell uses

The load cell is **required for v1** (HX711 + 5 kg cell under glass platform).

| Behavior | v1?  | Description |
| --- | ---- | --- |
| Glass present | Yes  | Block dispense if weight below threshold. |
| Ice handling | Yes  | Tare after user places glass plus ice. |
| Flow-gated pour start | Yes* | Start ml timers when liquid hits glass (*bench-gated). |
| Calibration | Yes  | Measure dispensed mass during calibration. |
| Pre-gate no-flow abort | Yes  | Pump runs; no flow within timeout → error. |
| Final sanity check | Yes  | Compare expected drink mass to measured increase. |
| Spill/overflow detection | Yes  | Unexpected weight changes can stop operation. |
| Per-ingredient mass stop | No | Deferred — sequential closed-loop (v2 if needed). |

## No-flow detection

**During pour (pre-gate):**

```text
if pumps_running and elapsed > flow_detect_timeout_ms and scale_delta_is_too_small:
    stop operation
    mark pump(s) as suspect/unprimed
    alert user
```

**After pour (sanity check):**

```text
if expected_mass_increase - measured_increase > sanity_threshold:
    warn user (cannot identify which pump in simultaneous mode)
```

Single-pump calibration or prime can attribute no-flow to one line. During simultaneous pours, pre-gate and sanity checks detect **aggregate** failure only.

## Bottle inventory tracking

Software-only tracking is acceptable. **ESP32 NVS is authoritative** for `remaining_ml` and related fields; the kiosk reads machine state for display. Cloud KV may mirror for analytics later but must not be the pour-time source of truth.

Pump ↔ ingredient bindings also live on the ESP32 (not in recipe documents). See [`16-firmware-and-software-architecture.md`](16-firmware-and-software-architecture.md).

Suggested fields:

```text
ingredient_name
pump_id
bottle_size_ml
remaining_ml
low_warning_ml
ml_per_second
primed
last_primed_at
last_cleaned_at
last_refilled_at
```

When a recipe is made:

```text
remaining_ml -= target_dispense_ml
```

When a bottle is changed/refilled:

```text
remaining_ml = configured_bottle_size_ml
primed = false or user_confirmed
```

## Inventory reserve

Do not assume the machine can extract every ml from a bottle.

Use a configurable dead-volume reserve:

```text
usable_volume_ml = bottle_size_ml - reserve_ml
```

Starting suggestions:

| Bottle size | Reserve warning |
| ---: | ---: |
| 375 ml | 40-60 ml |
| 750 ml | 75-100 ml |
| 1 L | 100-125 ml |

This accounts for pickup tube geometry, bottle shape, and priming uncertainty.

## Cleaning and inventory

Cleaning cycles should not subtract from ingredient inventory unless ingredient fluid is being intentionally wasted.

Possible states:

- Ingredient mode: subtract dispensed recipe volume.
- Prime mode: optionally subtract estimated prime waste.
- Water flush mode: do not subtract ingredient inventory.
- Sanitizer mode: do not subtract ingredient inventory.
- Drain mode: do not add liquid back to inventory unless intentionally designed and safe.

Do not reverse sanitizer or dirty line contents back into ingredient bottles.

## Calibration verification test

For each installed pump, after calibration:

1. Prime line.
2. Dispense 15 ml target three times.
3. Dispense 30 ml target three times.
4. Dispense 60 ml target three times.
5. Record actual output.
6. Decide whether the pump meets the selected good-enough tolerance.

If a pump fails:

- Check priming.
- Check tubing compression/kinks.
- Check supply voltage sag.
- Check nozzle restriction.
- Recalibrate with a longer calibration run.
- Replace pump/tubing if needed.
