cjlawson02/Rumtime/docs/bench-results/2026-07-12-session-03.md

# Bench session — 2026-07-12 (session 03)

Operator: **Chris**  
Prior session: [`2026-06-27-session-02.md`](2026-06-27-session-02.md)

## Goal

Exercise **product controller** + kiosk pour path on the 2-pump bench (Old Fashioned / P1+P2), plus cancel and Wi‑Fi disconnect safety — without the load cell.

## Pre-flight

- [x] Product firmware (`firmware/controller`) on ESP32-S3-DevKitC-1 (N16R8 / 8 MB profile)
- [x] Platform: **pioarduino 55.03.39** (Arduino-ESP32 **3.3.9** / IDF **5.5.4**) — not official PlatformIO `espressif32@7.0.1` (stuck on Arduino 2.0.17)
- [x] Kiosk UI against live device API
- [ ] Scale / HX711 — **not wired**; unused this session
- [x] Temporary **bench open-loop** enabled for recipe pours (`RUMTIME_BENCH_OPEN_LOOP` / timed-from-motor-on, no flow-gate) — removed from tree after this session’s validation

## Results

| Check | Result | Notes |
| ----- | --- | ----- |
| Old Fashioned sequential pour (P1+P2) | **Pass** | Happy path under open-loop; both pumps ran; kiosk progress / complete UI exercised |
| Cancel mid-pour | **Pass** | Cancel stops pumps; UI cancel / re-pour attempt-scoping fixed (stale `cancelled` latch no longer blocks next pour) |
| Wi‑Fi lost while busy → auto-stop | **Pass** | STA disconnect cancels busy job (same cancel path as HTTP/serial) |
| Kiosk HTTP heartbeat cancel | Implemented | Armed on HTTP-started jobs; `/status` refreshes; not separately logged this session |
| Flow-gate / Tests 7–9 | **Not run** | Scale not on bench |
| Measured ml repeatability (Test 4) | **Not re-run** | Session 02 numbers still stand for water cal |

## Issues / notes

- Open-loop was **temporary** so pours could proceed without scale; product default remains **flow-gated** once the load cell is online. Open-loop flag and serial override were removed after this session’s code cleanup.
- Machine status now surfaces `link` diagnostics (SSID, IP, RSSI, uptime, free heap, last disconnect reason) — useful for RF dropouts; not a formal RF test log this session.

## Next actions

1. Wire load cell + HX711; re-enable flow-gate path (open-loop already gone). → **Partial in [session 04](2026-07-12-session-04.md)** (MCU done; bar pending).
2. Formal Tests **7–9** (glass, ice, gated vs timed).
3. Re-check cancel + disconnect with flow-gate on.
4. Restricted outlet + Test 4/4b refresh if locking anti-drip for product.
