cjlawson02/Rumtime/docs/bench-results/2026-07-12-session-04.md

# Bench session — 2026-07-12 (session 04)

Operator: **Chris**  
Prior session: [`2026-07-12-session-03.md`](2026-07-12-session-03.md)

## Goal

Start HX711 bring-up on the product controller bench: MCU-side wiring and pin map, before soldering the load cell bar.

## Pre-flight

- [x] Estardyn / kit HX711 module on bench (no screw terminals — solder pads / header only)
- [x] Firmware pin map: **DT → GPIO 8**, **SCK → GPIO 9** (`kScaleDout` / `kScaleSck` in controller + bench-rig `config.h`)
- [x] HX711 ↔ ESP32-S3: **VCC 3.3 V**, **GND**, **DT**, **SCK** wired
- [ ] Load cell bar → HX711 **E+/E−/A+/A−** — **not soldered yet**
- [ ] Scale smoke-check / `scalecal` / Tests 7–9 — blocked on bar wiring

## Results

| Check | Result | Notes |
| ----- | --- | ----- |
| MCU → HX711 power + data | **Done** | 3.3 V / GND / DT=8 / SCK=9 |
| Load cell excitation + sense | **Pending** | Red E+, Black E−, Green A+, White A− still open |
| `scale_ready` / grams move | **Not verified** | Expect fail or stale until bar is soldered |

## Issues / notes

- Kit HX711 has **no screw terminals**; load-cell leads will solder to E+/E−/A+/A− pads with strain relief.
- B+/B− unused (single 5 kg bar on channel A).

## Next actions

1. Solder load cell to HX711 (Red E+, Black E−, Green A+, White A−); strain-relieve.
2. Reflash if not already on GPIO 8/9; `status` → confirm `scale_ready` and grams respond to load.
3. Tare + known-mass cal; then Tests **7–9**.
