cjlawson02/Rumtime/docs/bench-results/2026-07-19-session-05.md

# Bench session — 2026-07-19 (session 05)

Operator: **Chris**  
Focus: Four-pump-block FDM **fit coupons** (mount + tube clamp + channel)  
CAD: `hardware/cad/` — `four_pump_block_coupons.py`, `refs/four-pump-block.md`, `refs/kphm100-mount-plate.md`

## Goal

Print and fit-check the critical four-pump-block interfaces before committing to
full-size body / panels.

## Printed

- [x] `four_pump_block_mount_coupon` (first pass: 3 mm plate, Ø33 / Ø3.5)
- [x] `four_pump_block_tube_clamp_coupon` (cluster geometry)
- [ ] `four_pump_block_front_channel_coupon` — not logged this session
- [ ] Re-print mount coupon at **2 mm / Ø32 / Ø3.3** after CAD update

## Results

| Check | Result | Notes |
| ----- | --- | ----- |
| Mount hole pattern vs pump | **Pass** | Keyed M3 holes line up on the physical KPHM100 |
| Central pump / shim clearance (Ø33) | **Meh** | ~**1 mm** radial over the Ø31 mm rear shim — looser than needed |
| Tube clamp print / cluster shape | **Pass** | Coupon matches the top-panel cluster; snaps look right |
| Tube clamp on 5 mm OD silicone | **Pending** | Snap + retention not tested yet |
| Wall thickness (3 mm front / 4 mm top) | **Meh** | Felt too thick on coupons; thinned in CAD |

## Design changes from this session

Recorded in CAD + refs (not yet re-printed / re-validated):

| Parameter | Was | Now |
| --- | --- | --- |
| Floor / side / rear / front panel | 3 mm | **2 mm** |
| Top tube panel | 4 mm | **2 mm** |
| Central clearance opening | Ø33 mm | **Ø32 mm** (0.5 mm radial over Ø31 shim) |
| Mount screw clearance | Ø3.5 mm | **Ø3.3 mm** |

Clamp snap wall remains **1.5 mm** (separate from enclosure walls).

## Issues / notes

- First mount coupon confirmed pattern; clearance and panel thickness are the
  follow-up print, not a hole-pattern fail.
- Channel fit (U-channel vs 2 mm panel edge) still open.

## Next actions

1. Press 5 mm OD silicone into `four_pump_block_tube_clamp_coupon` — log snap and
   retention (pass/fail + any cavity/throat tweak).
2. Re-print mount coupon at 2 mm / Ø32 / Ø3.3; confirm shim clearance and screw
   fit; check screw engagement through 2 mm into pump blind holes.
3. Print `four_pump_block_front_channel_coupon`; slide mount-coupon edge for
   0.35 mm channel fit.
4. If 2–3 pass, print full front panel + body / top panel.
