cjlawson02/Rumtime/docs/bench-results/2026-08-16-session-06.md

# Bench session — 2026-08-16 (session 06)

Operator: **Chris**  
Focus: Load-cell **bar measurement** + bench cantilever FDM  
CAD: `hardware/cad/` — `load_cell_bar.py`, `load_cell_bench.py`, `refs/estardyn-load-cell.md`

Prior: [`2026-07-12-session-04.md`](2026-07-12-session-04.md) (HX711↔MCU wired; bar not soldered).

## Goal

Replace vendor-typical hole guesses with caliper values, print a simple
cantilever (cleat + pad + pins), then solder the bar to HX711 for Tests 7–9.

## Measured (bar on bench)

Position: 5 kg ↓ arrow on the **left** (load end), wires on the **right** (fixed
end), both on the **front** face. Holes **top-to-bottom**, through-tapped.

| Parameter | Value |
| --- | ----- |
| Envelope | **75 × 12.75 × 12.75 mm** (not 80 mm) |
| Hole Xs from load end | **5, 15, 59, 69 mm** (10 mm pairs; do not symmetrize) |
| Bore | **~Ø3.5 mm** calipers = **M4 tap** minor diameter (all four) |

Superseded: 15 mm pair spacing, M4/M5 mix, M3 through-holes.

## Printed

In Cura this session (STLs in `hardware/cad/out/`, gitignored):

- [x] `load_cell_fixed_cleat` — wire-end U-cleat + C-clamp tab (printing)
- [x] `load_cell_load_pad` — 70 mm nest pad, arrow end (printing)
- [x] `load_cell_bench_pin_set` — 4 headed taper pins for the M4 taps (printing)
- [ ] Fit check — pending print finish

Do **not** print `load_cell_bar` (metal cell) or `load_cell_base` / `load_cell_top` (110 mm product plates).

## Results

| Check | Result | Notes |
| ----- | --- | ----- |
| Vendor 80 mm / 15 mm / M4–M5 | **Fail vs this unit** | 75 mm, 10 mm pairs, all M4 tapped |
| Cleat / pad / pin FDM | **In progress** | Head-down pins, 100% infill |
| Bar → HX711 solder | **Still open** | Blocks `scale_ready` / Tests 7–9 |
| Pin press-fit in M4 taps | **Pending** | Finger-press only; tape/sand if needed |

## Next actions

1. Fit-check print: wire end in cleat, C-clamp **side tab** only, pad on arrow end, press pins. Log pass/fail.
2. Solder load cell to HX711 (Red E+, Black E−, Green A+, White A−); strain-relieve.
3. `status` → `scale_ready` and grams move; tare + known-mass cal; Tests **7–9**.
