cjlawson02/Rumtime/docs/bench-results/2026-08-16-session-07.md

# Bench session — 2026-08-16 (session 07)

Operator: **Chris**  
Focus: Bench cantilever **assembled**; 4-pump module **schematic v1** ERC-clean

Prior: [`2026-08-16-session-06.md`](2026-08-16-session-06.md) (bar measured; FDM started).

## Goal

Finish the printed cantilever, note PCB schematic status. No scale numbers this session.

## Printed / assembled

- [x] `load_cell_fixed_cleat`, `load_cell_load_pad`, `load_cell_bench_pin_set` printed
- [x] Bar assembled in cleat + pad with taper pins
- [ ] Fit-check measurements / pass-fail log — **not measured yet**
- [ ] Bar → HX711 solder — still open (Tests 7–9 blocked)

## 4-pump module (KiCad)

- [x] Schematic v1 complete; `hardware/kicad/scripts/check.sh` ERC **0 errors**
- [ ] PCB layout — **in progress** (silkscreen / placement; no DRC yet)

## Next actions

1. Measure/fit-check the assembled cantilever; log pass/fail.
2. Solder load cell to HX711 (Red E+, Black E−, Green A+, White A−); strain-relieve.
3. `status` → `scale_ready`; tare + known-mass cal; Tests **7–9**.
4. Finish 4-pump PCB layout (Pololu 12.7 mm row spacing, Edge.Cuts, pours, silkscreen). Fab still waits on Test 10.

**2026-10-25:** Clone measured at **15.25 mm** between header rows, body **21 × 18 mm**. The layout pitch already matches. Do not move the sockets to 12.7 mm. [`hardware/kicad/4-pump-module-spec.md`](../../hardware/kicad/4-pump-module-spec.md).
