cjlawson02/Rumtime/docs/bench-results/2026-08-20-session-08.md

# Bench session — 2026-08-20 (session 08)

Operator: **Chris**  
Focus: Load-cell **solder + known-mass cal** (Tests 7.1 smoke)

Prior: [`2026-08-16-session-07.md`](2026-08-16-session-07.md) (cantilever printed/assembled; bar unsoldered).

## Goal

Wire Estardyn 5 kg bar → HX711 → ESP32-S3, confirm `scale_ready`, tare, calibrate with known masses.

## Pre-flight

- [x] HX711 ↔ ESP32-S3: VCC **3.3 V**, GND, DT **GPIO 8**, SCK **GPIO 9** (session 04)
- [x] Bar → HX711 solder: **Red E+**, **Black E−**, **Green A+**, **White A−** (B+/B− unused)
- [x] Printed cantilever (cleat + pad + taper pins) from session 07
- [x] Firmware: `firmware/bench-rig` + `scripts/scaleplot.py` live plotter

## Results

| Check | Result | Notes |
| ----- | --- | ----- |
| `scale_ready` | **yes** | Unwired `raw` stuck at 0; after solder, counts move with load |
| Empty tare | **Pass** | Stable near 0 g (Test 7.1) |
| 180 g known mass | **180.7 g** pre-fit (factor 368.1 from 206 g phone) | |
| 714 g known mass | **727.4 g** pre-fit | |
| LS factor | **`scalecal 374.76`** | Empty-tare raw ≈ −192443; 180 g raw ≈ −125857; 714 g raw ≈ +75356 |
| Fit residual | 180 g → **177.7 g** (−2.3 g); 714 g → **714.6 g** (+0.6 g) | Operator: **success** |
| iPhone 14 Pro (206 g spec) | Used to flip sign off stock **−7050** | Intermediate only; not in the LS fit |

Stock bogde-style **−7050** was the wrong sign and ~19× too coarse for this mount.

## Not done this session

- Test **7.2–7.6** (glass, ice, pour mass, no-glass abort, vibration floor)
- Test **9** flow-gated vs timed
- Fit-check measurements of printed cleat/pad (still open from session 07)

**Operator call:** bar bring-up is **done**. Remaining Test 7 / Test 9 **deferred** — not the next bench item. Flow-gated pour stays the v1 default in `docs/01-decisions.md`; vibration/flow-gate proof waits until we need it.

## Next actions

1. Empty tare after RST (done — factor flashed in `config.h`).
2. 4-pump PCB layout / **DRC** as the fab gate (Test 10 is first-article I2C).
3. Fit-check the printed cantilever when convenient; optional M4 screws later.
