cjlawson02/Rumtime/docs/bench-results/2026-06-27-session-01.md

# Bench session — 2026-06-27 (session 01)

Operator: **Chris**  
Board: ESP32-S3-DevKitC-1, module **N16R8** (firmware uses default 8 MB PlatformIO profile)  
Firmware: `firmware/bench-rig/` — USB CDC serial @ 115200 baud  
Pumps: KPHM100-HBB10 — P1 on TB6612 A+/A−; P2 not on motor bus yet; **not labeled yet**  
PSU: bench **DC supply with current limiter** (interim — not Mean Well GST60A12 + inline fuse/cutoff yet)  
Tubing: **3×5 mm class** — visual fit OK; caliper measurement waived

## Completed this session

### Electronics bring-up

- [x] Firmware built, flashed, serial monitor working (native USB `/dev/cu.usbmodem*`)
- [x] ESP32-S3 ↔ TB6612 logic wired (GPIO 4–7, 15–17, 3.3 V, GND)
- [ ] HX711 + load cell bar — **not wired** (ordered 2026-06-23; **both ship together** — not in hand as of 2026-06-27)
- [x] P1 motor on 12 V pump bus — forward and reverse spin correctly
- [x] Serial commands verified: `status`, `run`, `stop` (`stop` → immediate stop, Test 8.3)

### Test 1 — partial (dry, P1)

| Step | Result | Notes |
| ---- | --- | ----- |
| 1.1 | **Open** | 12 V at PSU no-load not logged |
| 1.2 | **0.20–0.21 A** | P1 forward, dry, no liquid; PSU front-panel ammeter |
| 1.3 | **Open** | Dry stall not measured |
| 1.3b | **Open** | Wet stall — no tubing/water yet |
| 1.4 | **Waived** | P2 stall skipped — same motor class; see session 02 |
| 1.5 | **~0.4 A wet** | Session 02 — `run both fwd`; see session 02 |
| 1.5b | **Open** | — |
| 1.6 | **N/A (interim)** | No hardware cutoff yet — using PSU current limiter + `stop` for bench; add fuse/cutoff before integrated rig |

**Preliminary:** I_run ≈ 0.21 A ≪ TB6612 ~1.2 A continuous target — driver choice looks validated for dry run.

**Interim power note:** Current-limited bench PSU is acceptable for **initial** bench testing at the bench. Before leaving the rig unattended or moving to liquid/syrup sessions, add **inline fuse + main power cutoff** per mini-BOM (no separate pump-bus switch).

### Test 8 — partial

| Step | Result | Notes |
| ---- | --- | ----- |
| 8.1 | **Pass** | Reset during dispense — pumps stop or remain off |
| 8.2 | Open | |
| 8.3 | **Pass** | `stop` stops pump |

## Not started

- Setup: pump labels (P1/P2), barbs/clamps, leak check, restricted outlet (sessions 01–02: open ~3 mm tube only)
- HX711 + load cell bar wiring (when load cell bar arrives)
- Test 2 — prime and leak (water)
- Test 3 — flow calibration
- Tests 4–7, 9–10
- Formal bench log fields: stall wet/dry, ml/s, anti-drip, flow-gate tuning

## Issues / notes

- ESP32-S3 N16R8 **PSRAM/16 MB flash** PlatformIO profile caused boot loop; reverted to default 8 MB board profile (works; extra flash unused).
- **Procurement:** Phase 0 bulk order placed 2026-06-18; parts **received 2026-06-27**. Load cell bar + HX711 ordered 2026-06-23 (same shipment) — still in transit; scale path not on bench yet.
- Automated serial scripts can put S3 into USB download mode; use open monitor + RST for interactive testing.

## Next actions

→ **Session 02 runbook:** [`2026-06-27-session-02.md`](2026-06-27-session-02.md)

1. Label P1/P2; prime P1 with water if not already (Test 2).
2. Log 1.1 V_no_load and PSU current-limit setting used.
3. Log 1.3 stall dry/wet, wet I_run.
4. Wire P2 to B+/B−; repeat electrical checks.
5. Flow cal: `prime 1` → `cal run 1 20` → `cal 1 <ml/s>` (Test 3).
6. Before longer liquid sessions: add **fuse + cutoff** on pump bus (replace interim PSU-only safety).
