cjlawson02/Rumtime/docs/bench-results/2026-06-27-session-02.md

# Bench session — 2026-06-27 (session 02)

Operator: **Chris**  
Prior session: [`2026-06-27-session-01.md`](2026-06-27-session-01.md)

## Goal

Finish Test 1 gaps that need tubing/water, run **Test 2** (prime + leak) on P1, **Test 3** flow cal on P1.

## Pre-flight (before water)

- [ ] Label pumps **P1** / **P2** on motor and tubing runs _(skipped this session)_
- [x] Caliper tubing: **waived** — visual 3×5 mm class; primes and pours OK
- [x] Log PSU: V_no_load = **12 V**, current limit = **5 A**
- [x] Graduated cylinder (250 ml, ±2.5 ml @ 20 °C), catch tray
- [x] Serial monitor; `status` OK; firmware re-flashed (serial `prime` fix)

## Test 1 — finish (P1)

| Step | Result | Notes |
| ---- | --- | ----- |
| 1.1 | **12 V** | No-load at pump bus |
| 1.3 dry | **0.9 A** | Rotor stalled completely, dry |
| 1.2 wet | **~0.2 A** | Primed, open outlet; same as dry ~0.21 A |
| 1.3b wet | **~0.33 A** | Outlet blocked ~5 s, line primed |

**TB6612:** All measured currents ≪ ~1.2 A continuous target — driver OK for P1 on this bench.

## Test 2 — prime and leak (P1)

| Step | Result | Notes |
| ---- | --- | ----- |
| 2.1 P1 prime | **Pass** | No leaks; nozzle wet |
| 2.3 5 min soak | **Pass** | No leaks at barbs/clamps after 5 min |

**Prime:** ~**2500 ms** on short bench tubing (~40–60 cm runs). **Not a product constant** — varies with line length and final routing.

## Test 3 — flow cal (P1)

Method: single long run (60 s) into 250 ml cylinder vs protocol default 20 s.

| Run | Time (s) | ml | ml/s | Notes |
| --- | ---: | --: | ---: | ----- |
| P1 cal | 60 | **100** | **1.67** → **1.75** | Initial 1.67; tuned via `dispense 1 50` (55→45→**~48 ml**) |
| P1 repeat | — | — | — | **50 ml × multiple trials: consistent ~48 ml** — pass |

**Verify pour:** `dispense 1 30` → ~29 ml; `dispense 1 50` @ **cal 1 1.75** → **~48 ml**, repeats consistent — **Test 4 pass (50 ml target)**.

## Test 4 — pour repeatability (partial)

| Target (ml) | Trial | Actual (ml) | Pass? |
| ---: | ----: | ---: | ----- |
| 30 | 1 | ~29 | Yes |
| 50 | multiple | ~48 (consistent) | Yes |
| 50 P2 | 1 | **~50** (spot on) | Yes @ cal 1.75 |

| Test 1.5 dual run | **~0.4 A** | `run both fwd` — wet, both lines; ~2× single ~0.2 A |

## P2 bring-up (same bench session)

| Step | Result | Notes |
| ---- | --- | ----- |
| Wired B+/B− | **Done** | — |
| `cal 2 1.75` | **Pass** | Same rate as P1 — no separate 60 s cal needed on bench |
| `dispense 2 50` | **~50 ml** | Spot on |
| Test 1 (P2 electrical) | **Waived** | Same KPHM100 class as P1; 1.75 ml/s + dual ~0.4 A — stall not repeated |

**Finding:** P1 and P2 match at **1.75 ml/s** on this KPHM100 pair — good for modular cartridges.

## Test 5 — anti-drip (partial)

| Pump | Reverse (ms) | Result |
| ---- | ---: | --- |
| P1 | **100** | Good enough — minimal de-prime vs 400 ms |
| P2 | **100** | Good enough |

```text
antidrip 1 100
antidrip 2 100
```

## Test 4b — sequential pours (P2, anti-drip on)

`prime 2 5000`, then three pours **without re-prime** (50 ml total target):

```text
dispense 2 17
dispense 2 17
dispense 2 16
```

| Pour | Target (ml) | Notes |
| ---- | ---: | ----- |
| 1 | 17 | anti-drip 100 ms after each |
| 2 | 17 | |
| 3 | 16 | |
| **Total** | **50** | **~45 ml measured** |

**Under-pour (~5 ml):** attributed to **100 ms anti-drip reverse** pulling fluid back into the line on each pour (~1.5–2 ml per cycle). For volume-cal tests use `antidrip 0`; keep 100 ms for drip control tuning.

Bench bring-up firmware only — **production firmware will differ** (flow-gated dispense, etc.).

## Issues / notes

- Serial `prime` returned “unknown command” on old firmware / copy-paste input — fixed in bench-rig (robust line parsing + `benchPollSerial`); re-flashed 2026-06-27.
- Default **anti-drip 400 ms** de-primes short bench lines; **100 ms** OK for both pumps on bench.
- **Procurement:** Ordered **4** pumps; **2× 24 V** wrong variants returned — only **2× 12 V HB** on bench (P1+P2). Spare/P3 pending replacement.
- **Procurement:** Ordered barb unions (Quickun B08L5DTRCK class) mis-shipped as **smooth silicone couplers** — **not yet returned** (post office pending). Measured **1.8 mm ID** vs **3 mm** line tubing. Not barbed; not used for inline joins. Bench lines use pump-head barbs only; outlet was **open ~3 mm tube** (no restricted tip) for all pours this session.

## Next actions

1. **Test 1.5b:** V_sag on **Mean Well GST60A12** (fused pump bus) — large bench supply showed no sag; not representative.
2. **Test 4b:** P1 30 ml × 3 still open; P2 split pour logged (50 target → ~45 ml, anti-drip).
3. **Restricted outlet** — install tip (1.8 mm ID coupler on outlet or dedicated nozzle); re-run flow cal + anti-drip (sessions 01–02 on open outlet).
4. Load-cell Tests **7–9** (glass on platform, `dispense-gated`).
5. Before longer liquid sessions: **inline fuse + main power cutoff**.
6. Re-order **barbed** unions; confirm **12 V HB** replacements for returned pumps.
