cjlawson02/Rumtime/hardware/kicad/4-pump-module/4-pump-module.kicad_pcb

## KiCad design hardware/kicad/4-pump-module/4-pump-module.kicad_pcb (2026-10-30)

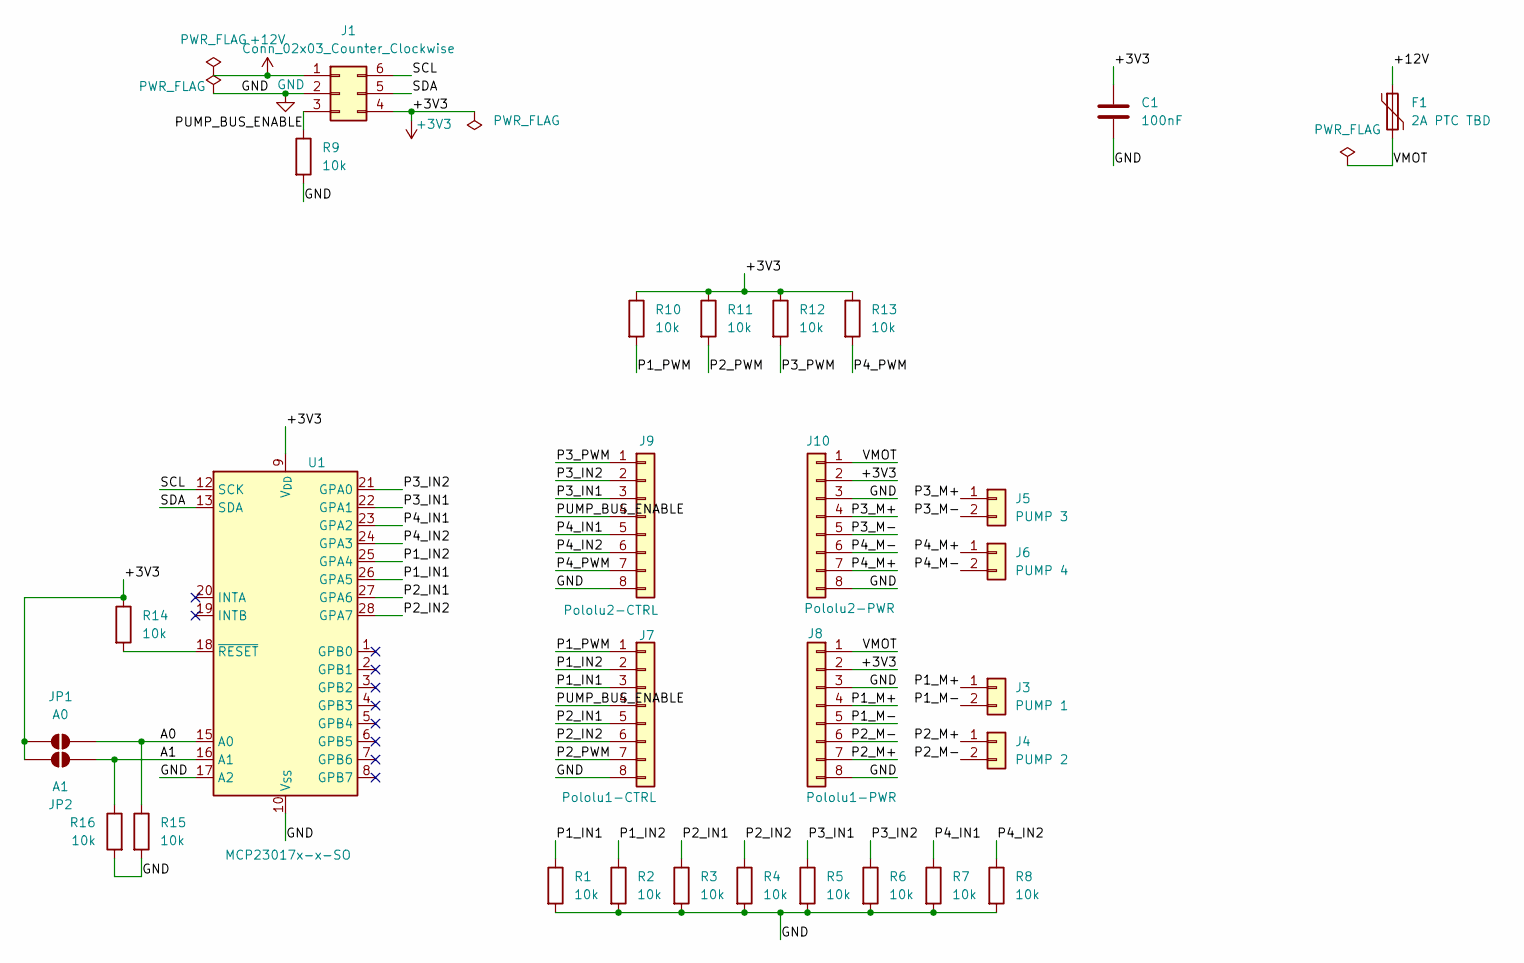
[picture p1: schematic 4-pump-module.kicad_sch, Rumtime 4-pump module]

Parts:
C1: 100nF; C_0805_2012Metric_Pad1.18x1.45mm_HandSolder
F1: 2A PTC TBD; Fuse_1812_4532Metric_Pad1.30x3.40mm_HandSolder
J1: Conn_02x03_Counter_Clockwise; Molex_Micro-Fit_3.0_43045-0600_2x03_P3.00mm_Horizontal
J3: PUMP 1; JST_XH_B2B-XH-A_1x02_P2.50mm_Vertical
J4: PUMP 2; JST_XH_B2B-XH-A_1x02_P2.50mm_Vertical
J5: PUMP 3; JST_XH_B2B-XH-A_1x02_P2.50mm_Vertical
J6: PUMP 4; JST_XH_B2B-XH-A_1x02_P2.50mm_Vertical
J7: Pololu1-CTRL; PinSocket_1x08_P2.54mm_Vertical
J8: Pololu1-PWR; PinSocket_1x08_P2.54mm_Vertical
J9: Pololu2-CTRL; PinSocket_1x08_P2.54mm_Vertical
J10: Pololu2-PWR; PinSocket_1x08_P2.54mm_Vertical
JP1: A0; SolderJumper-2_P1.3mm_Open_Pad1.0x1.5mm
JP2: A1; SolderJumper-2_P1.3mm_Open_Pad1.0x1.5mm
R1, R2, R3, R4, R5, R6, R7, R8, R9, R10, R11, R12, R13, R14, R15, R16: 10k; R_0805_2012Metric_Pad1.20x1.40mm_HandSolder
U1: MCP23017x-x-SO; SOIC-28W_7.5x17.9mm_P1.27mm

Connections:
+3V3: C1.1, J1.4, J8.2, J10.2, JP1.1 (A), JP2.1 (A), R10.1, R11.1, R12.1, R13.1, R14.1, U1.9 (V_{DD})
+12V: F1.1, J1.1
/A0: JP1.2 (B), R15.1, U1.15 (A0)
/A1: JP2.2 (B), R16.1, U1.16 (A1)
/P1_IN1: J7.3, R1.1, U1.26 (GPA5)
/P1_IN2: J7.2, R2.1, U1.25 (GPA4)
/P1_M+: J3.1, J8.4
/P1_M-: J3.2, J8.5
/P1_PWM: J7.1, R10.2
/P2_IN1: J7.5, R3.1, U1.27 (GPA6)
/P2_IN2: J7.6, R4.1, U1.28 (GPA7)
/P2_M+: J4.1, J8.7
/P2_M-: J4.2, J8.6
/P2_PWM: J7.7, R11.2
/P3_IN1: J9.3, R5.1, U1.22 (GPA1)
/P3_IN2: J9.2, R6.1, U1.21 (GPA0)
/P3_M+: J5.1, J10.4
/P3_M-: J5.2, J10.5
/P3_PWM: J9.1, R12.2
/P4_IN1: J9.5, R7.1, U1.23 (GPA2)
/P4_IN2: J9.6, R8.1, U1.24 (GPA3)
/P4_M+: J6.1, J10.7
/P4_M-: J6.2, J10.6
/P4_PWM: J9.7, R13.2
/PUMP_BUS_ENABLE: J1.3, J7.4, J9.4, R9.1
/SCL: J1.6, U1.12 (SCK)
/SDA: J1.5, U1.13 (SDA)
/VMOT: F1.2, J8.1, J10.1
GND: C1.2, J1.2, J7.8, J8.3, J8.8, J9.8, J10.3, J10.8, R1.2, R2.2, R3.2, R4.2, R5.2, R6.2, R7.2, R8.2, R9.2, R15.2, R16.2, U1.10 (V_{SS}), U1.17 (A2)
unnamed: R14.2, U1.18 (~RESET)

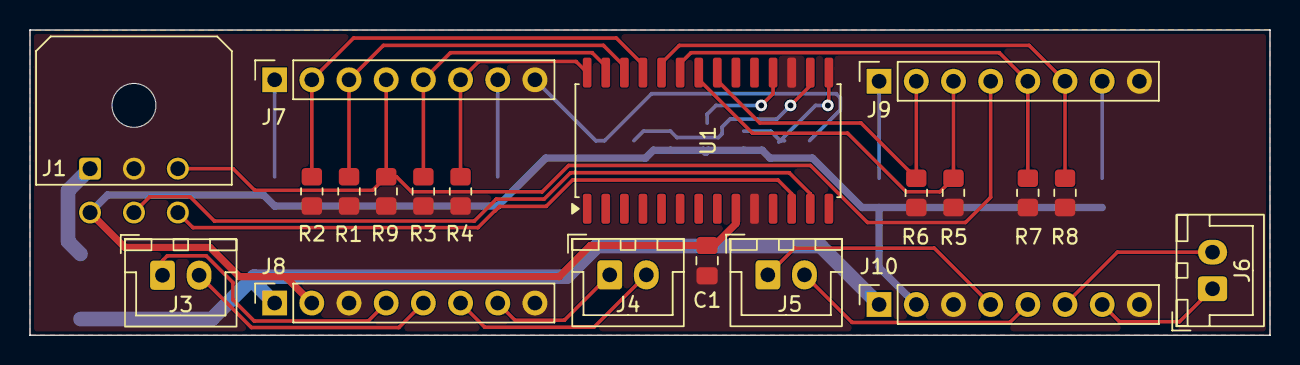
[picture p2: board 4-pump-module.kicad_pcb from above]

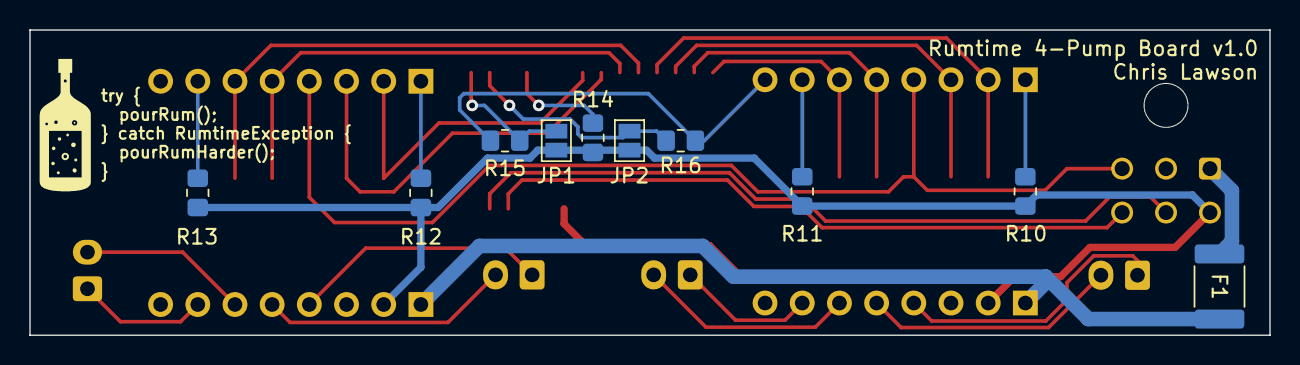
[picture p3: board 4-pump-module.kicad_pcb from below]

Board: 2 copper layers, 84.7 x 20.9 mm, 30 parts (10 on the bottom side), 30 nets.
