cjlawson02/Rumtime/hardware/kicad/main-controller/main-controller.kicad_pcb

## KiCad design hardware/kicad/main-controller/main-controller.kicad_pcb (2026-10-30)

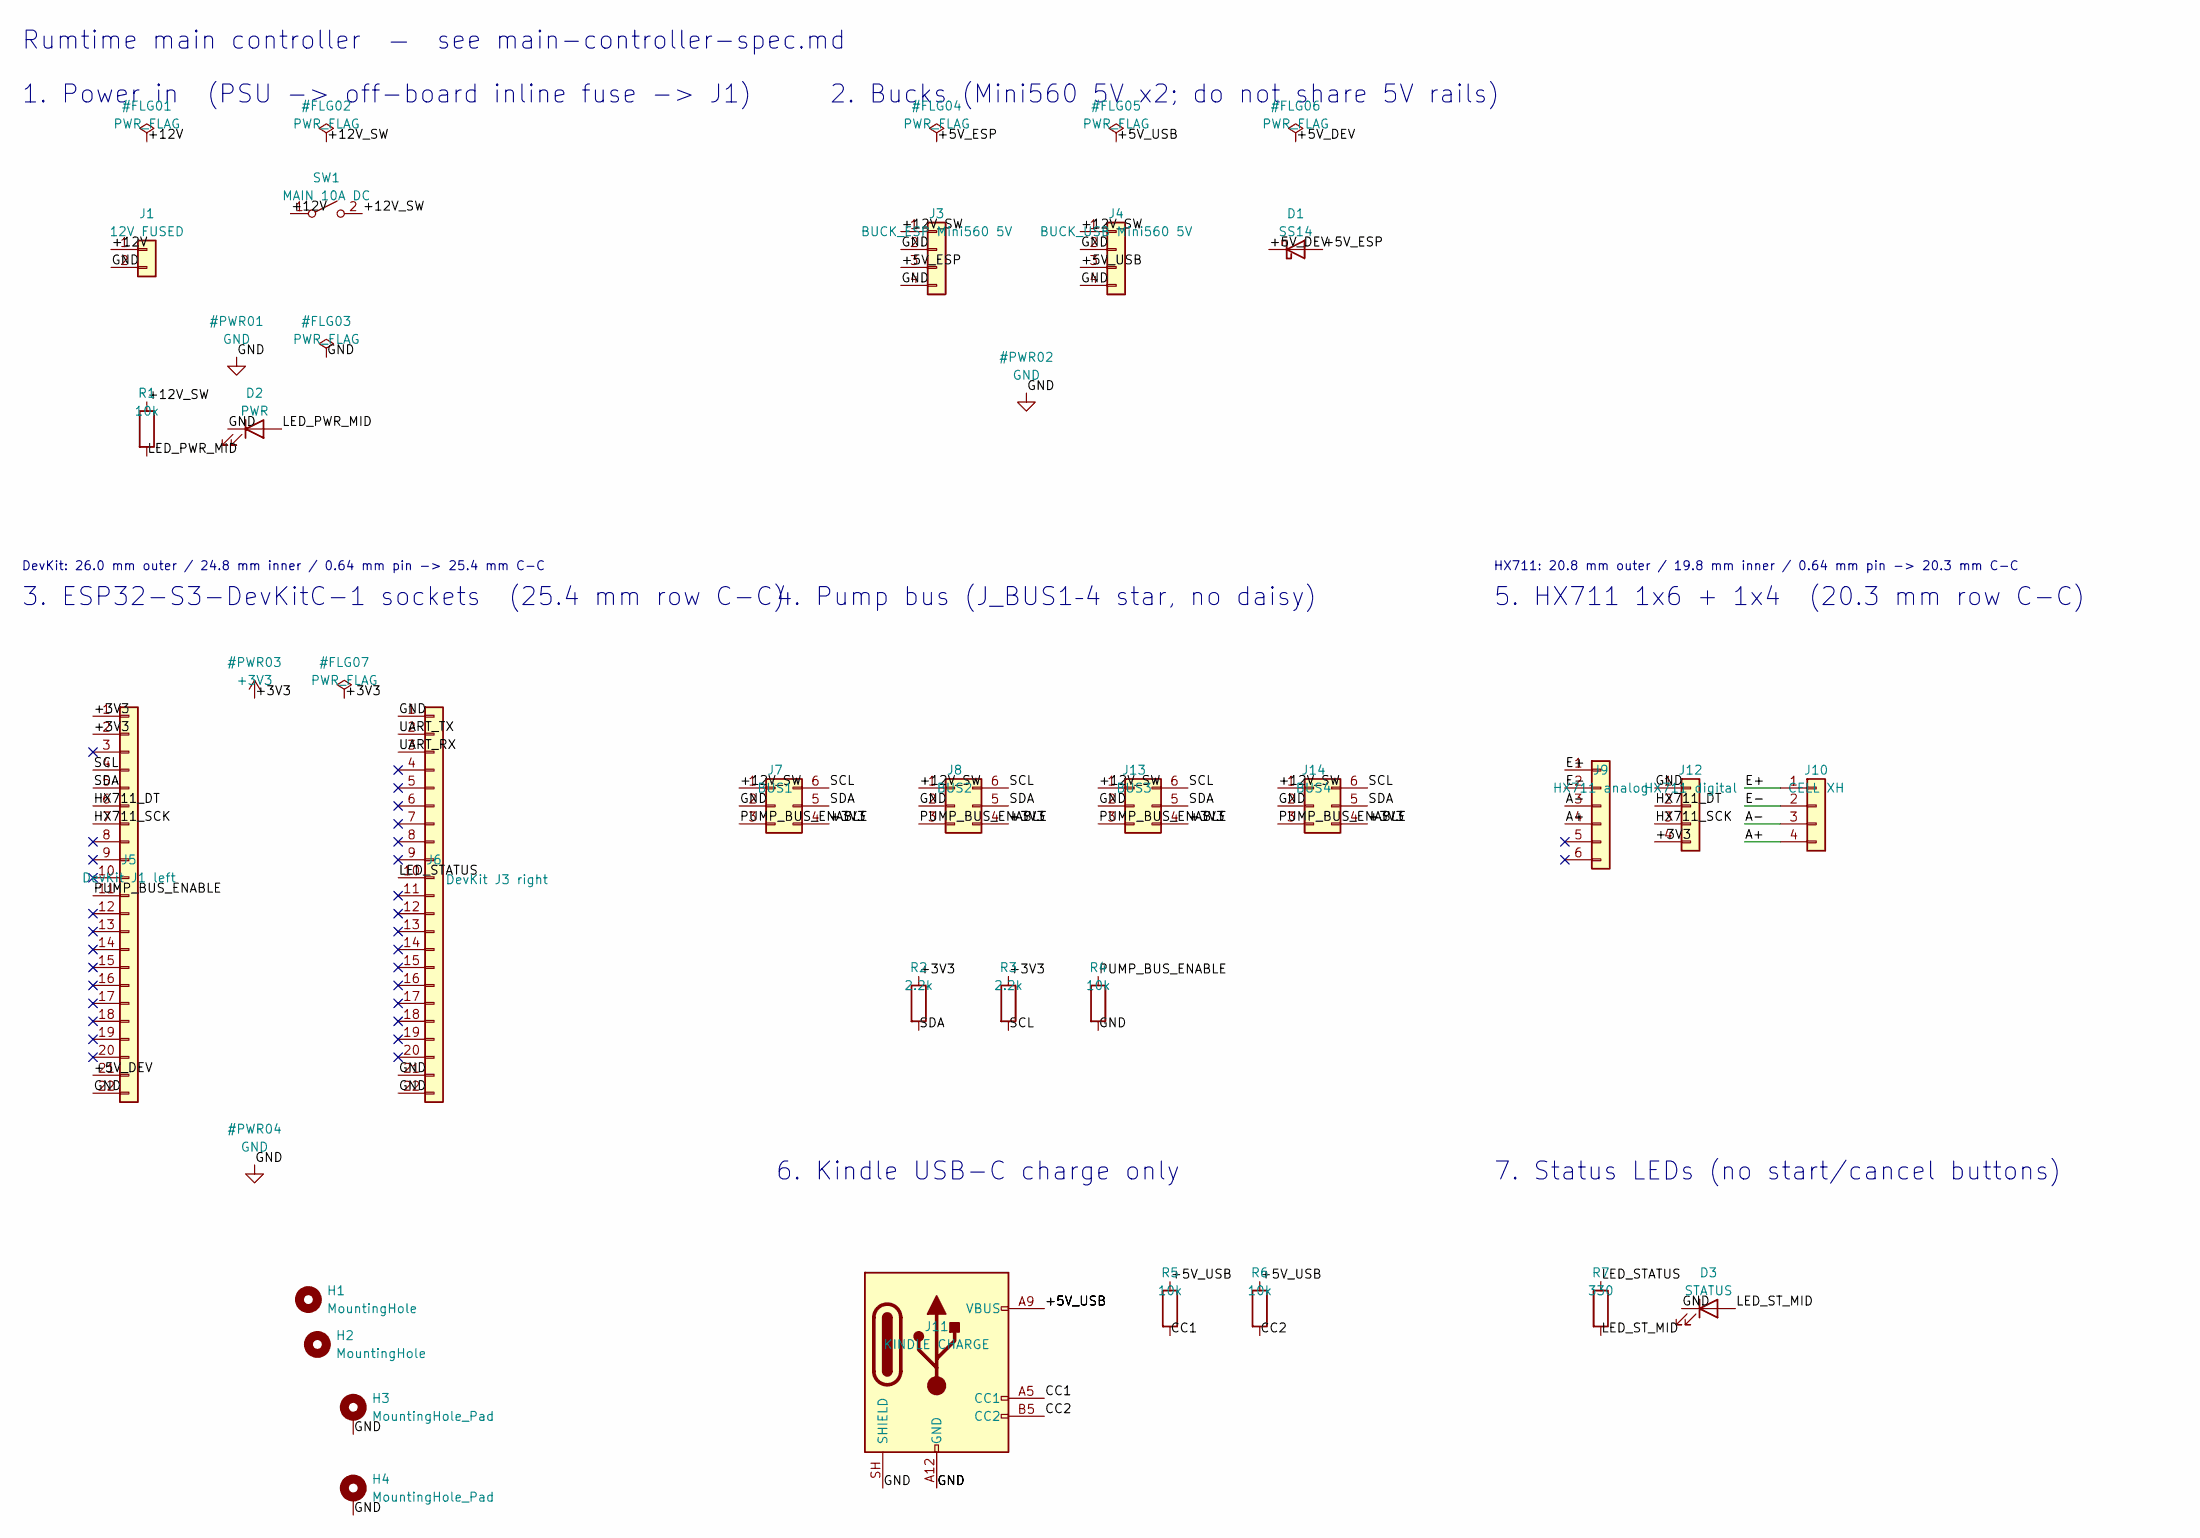
[picture p4: schematic main-controller.kicad_sch, Rumtime main controller]

Parts:
D1: SS14; D_SMA
D2: PWR; LED_D3.0mm
D3: STATUS; LED_D3.0mm
H1, H2: MountingHole; MountingHole_3.2mm_M3
H3, H4: MountingHole_Pad; MountingHole_3.2mm_M3_Pad
J1: 12V FUSED; TerminalBlock_Phoenix_MKDS-1,5-2-5.08_1x02_P5.08mm_Horizont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
J3: BUCK_ESP Mini560 5V; Mini560
J4: BUCK_USB Mini560 5V; Mini560
J5: DevKit J1 left; PinSocket_1x22_P2.54mm_Vertical
J6: DevKit J3 right; PinSocket_1x22_P2.54mm_Vertical
J7: BUS1; Molex_Micro-Fit_3.0_43045-0612_2x03_P3.00mm_Vertical
J8: BUS2; Molex_Micro-Fit_3.0_43045-0612_2x03_P3.00mm_Vertical
J9: HX711 analog; PinSocket_1x06_P2.54mm_Vertical
J10: CELL XH; JST_XH_B4B-XH-A_1x04_P2.50mm_Vertical
J11: KINDLE CHARGE; USB_C_Receptacle_GCT_USB4125-xx-x-0190_6P_TopMnt_Horizontal
J12: HX711 digital; PinSocket_1x04_P2.54mm_Vertical
J13: BUS3; Molex_Micro-Fit_3.0_43045-0612_2x03_P3.00mm_Vertical
J14: BUS4; Molex_Micro-Fit_3.0_43045-0612_2x03_P3.00mm_Vertical
R1, R4, R5, R6: 10k; R_0805_2012Metric
R2, R3: 2.2k; R_0805_2012Metric
R7: 330; R_0805_2012Metric
SW1: MAIN 10A DC; TerminalBlock_Phoenix_MKDS-1,5-2-5.08_1x02_P5.08mm_Horizont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

Connections:
+3V3: J5.1, J5.2, J7.4, J8.4, J12.4, J13.4, J14.4, R2.1, R3.1
/+5V_DEV: D1.1 (K), J5.21
/+5V_ESP: D1.2 (A), J3.3
/+5V_USB: J4.3, J11.A9 (VBUS), J11.B9 (VBUS), R5.1, R6.1
/+12V: J1.1, SW1.1 (A)
/+12V_SW: J3.1, J4.1, J7.1, J8.1, J13.1, J14.1, R1.1, SW1.2 (B)
/A+: J9.4, J10.4
/A-: J9.3, J10.3
/CC1: J11.A5 (CC1), R5.2
/CC2: J11.B5 (CC2), R6.2
/E+: J9.1, J10.1
/E-: J9.2, J10.2
/HX711_DT: J5.6, J12.2
/HX711_SCK: J5.7, J12.3
/LED_PWR_MID: D2.2 (A), R1.2
/LED_STATUS: J6.10, R7.1
/LED_ST_MID: D3.2 (A), R7.2
/PUMP_BUS_ENABLE: J5.11, J7.3, J8.3, J13.3, J14.3, R4.1
/SCL: J5.4, J7.6, J8.6, J13.6, J14.6, R3.2
/SDA: J5.5, J7.5, J8.5, J13.5, J14.5, R2.2
/UART_RX: J6.3
/UART_TX: J6.2
GND: D2.1 (K), D3.1 (K), H3.1 (1_1), H4.1 (1_1), J1.2, J3.2, J3.4, J4.2, J4.4, J5.22, J6.1, J6.21, J6.22, J7.2, J8.2, J11.A12 (GND), J11.B12 (GND), J11.SH (SHIELD), J12.1, J13.2, J14.2, R4.2

Notes on the sheet:
Rumtime main controller — see main-controller-spec.md
2. Bucks (Mini560 5V x2; do not share 5V rails)
HX711: 20.8 mm outer / 19.8 mm inner / 0.64 mm pin -> 20.3 mm C-C
7. Status LEDs (no start/cancel buttons)
5. HX711 1x6 + 1x4 (20.3 mm row C-C)
4. Pump bus (J_BUS1–4 star, no daisy)
3. ESP32-S3-DevKitC-1 sockets (25.4 mm row C-C)
DevKit: 26.0 mm outer / 24.8 mm inner / 0.64 mm pin -> 25.4 mm C-C
6. Kindle USB-C charge only
1. Power in (PSU -> off-board inline fuse -> J1)

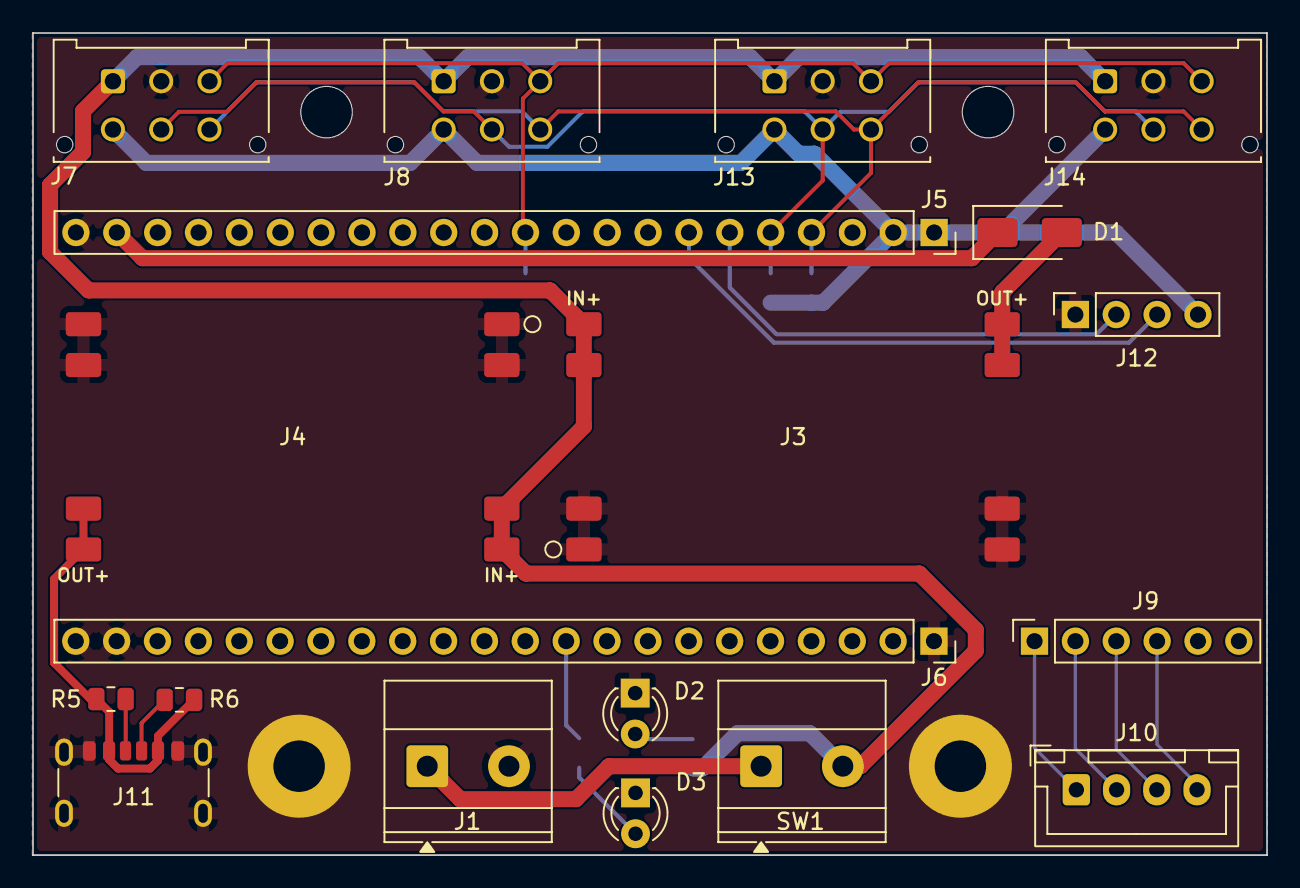
[picture p5: board main-controller.kicad_pcb from above]

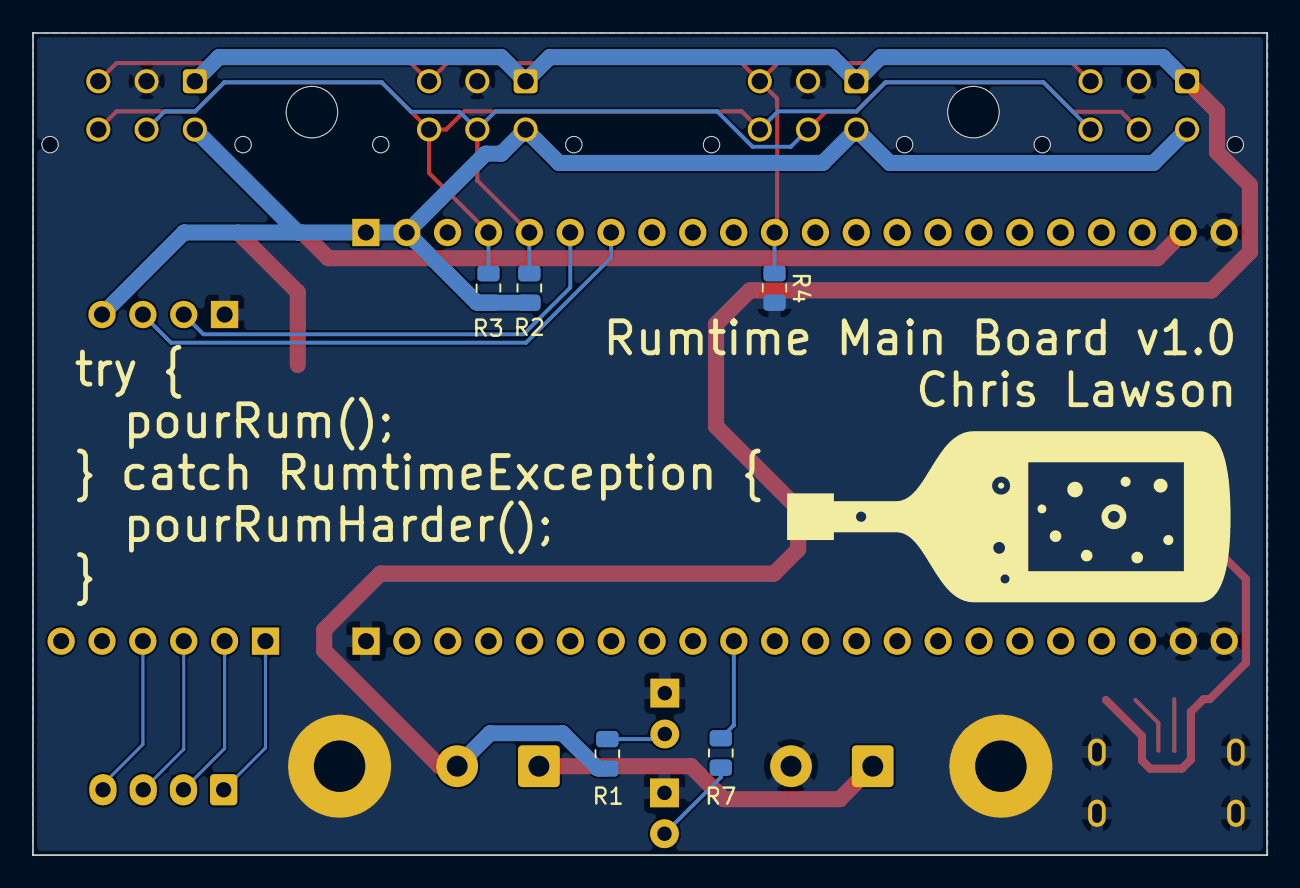
[picture p6: board main-controller.kicad_pcb from below]

Board: 2 copper layers, 76.7 x 51.1 mm, 28 parts (5 on the bottom side), 21 nets.
