cjlawson02/Rumtime/firmware/controller/src/pump_bus.cpp

#include "pump_bus.h"

#include "config.h"

namespace {

int clampDuty(int duty) {
  if (duty < 0) {
    return 0;
  }
  if (duty > 255) {
    return 255;
  }
  return duty;
}

}  // namespace

void PumpBus::begin(const GpioOps& gpio) {
  initialized_ = false;
  driver_enabled_ = false;
  gpio_ = &gpio;
  max_concurrent_ = kMaxConcurrentPumps;
  if (max_concurrent_ > kNumChannels) {
    max_concurrent_ = kNumChannels;
  }
  if (max_concurrent_ < 1) {
    max_concurrent_ = 1;
  }

  // Safe boot ordering: STBY low first so channel writes cannot drive motors,
  // then park each channel with IN1/IN2 low and PWM off.
  gpio_->pinMode(pins::kStandby, kGpioModeOutput);
  gpio_->digitalWrite(pins::kStandby, kGpioLevelLow);

  channels_[0].begin(pins::kPump1In1, pins::kPump1In2, pins::kPump1Pwm, gpio);
  channels_[1].begin(pins::kPump2In1, pins::kPump2In2, pins::kPump2Pwm, gpio);
  initialized_ = true;
}

void PumpBus::setMaxConcurrent(uint8_t max_concurrent) {
  if (max_concurrent < 1) {
    max_concurrent_ = 1;
  } else if (max_concurrent > kNumChannels) {
    max_concurrent_ = kNumChannels;
  } else {
    max_concurrent_ = max_concurrent;
  }
}

bool PumpBus::run(uint8_t channel, PumpDirection direction, int duty) {
  if (channel >= kNumChannels) {
    return false;
  }
  if (!initialized_) {
    return false;
  }
  if (direction == PumpDirection::kStop) {
    stop(channel);
    return true;
  }
  const bool already_running = channels_[channel].direction() != PumpDirection::kStop;
  if (!already_running && runningCount() >= max_concurrent_) {
    return false;
  }
  channels_[channel].run(direction, clampDuty(duty));
  enableDriver();
  return true;
}

void PumpBus::stop(uint8_t channel) {
  if (!initialized_ || channel >= kNumChannels) {
    return;
  }
  channels_[channel].stop();
  if (!anyRunning()) {
    disableDriver();
  }
}

void PumpBus::stopAll() {
  if (!initialized_) {
    return;
  }
  for (uint8_t i = 0; i < kNumChannels; ++i) {
    channels_[i].stop();
  }
  disableDriver();
}

bool PumpBus::anyRunning() const {
  return runningCount() > 0;
}

uint8_t PumpBus::runningCount() const {
  uint8_t count = 0;
  for (uint8_t i = 0; i < kNumChannels; ++i) {
    if (channels_[i].direction() != PumpDirection::kStop) {
      ++count;
    }
  }
  return count;
}

void PumpBus::enableDriver() {
  if (!initialized_ || gpio_ == nullptr || driver_enabled_) {
    return;
  }
  gpio_->digitalWrite(pins::kStandby, kGpioLevelHigh);
  driver_enabled_ = true;
}

void PumpBus::disableDriver() {
  if (!initialized_ || gpio_ == nullptr || !driver_enabled_) {
    return;
  }
  gpio_->digitalWrite(pins::kStandby, kGpioLevelLow);
  driver_enabled_ = false;
}
