cjlawson02/Rumtime/firmware/controller/include/device_status.h

#pragma once

#include <cstdint>
#include <string>

#include "config.h"
#include "status_snapshot.h"

// Wire values for StatusSnapshot::pump_job_purpose (maps to kiosk pumpJobPurposeSchema).
enum class PumpJobPurposeWire : uint8_t {
  kNone = 0,
  kPrime = 1,
  kCalibration = 2,
  kVerify = 3,
};

struct DeviceStatusInputs {
  bool wifi_connected = false;
  const char* hostname = kMdnsHostFqdn;
  const char* firmware_version = kFirmwareVersion;
  unsigned long now_ms = 0;
  const StatusSnapshot* snapshot = nullptr;

  // Optional link diagnostics for Machine status (may be empty / zero when offline).
  const char* wifi_ssid = "";
  const char* wifi_ip = "";
  int wifi_rssi = 0;
  uint8_t wifi_last_disconnect_reason = 0;
  unsigned long uptime_ms = 0;
  uint32_t free_heap = 0;
};

std::string buildDeviceStatusJson(const DeviceStatusInputs& in);

int computeTimedPumpProgressPercent(unsigned long elapsed_ms, unsigned long duration_ms);
const char* pourStepLabel(const char* ingredient_id);
const char* pumpJobStepLabel(PumpJobPurposeWire purpose);
