cjlawson02/Rumtime/firmware/controller/src/status_snapshot.cpp

#include "status_snapshot.h"

void StatusPublisher::begin() {
  seq_.store(0, std::memory_order_relaxed);
  latest_ = StatusSnapshot{};
}

void StatusPublisher::publish(const StatusSnapshot& snapshot) {
  seq_.fetch_add(1, std::memory_order_release);
  latest_ = snapshot;
  seq_.fetch_add(1, std::memory_order_release);
}

StatusSnapshot StatusPublisher::read() const {
  for (int attempt = 0; attempt < 64; ++attempt) {
    const uint32_t before = seq_.load(std::memory_order_acquire);
    if (before & 1U) {
      continue;
    }
    StatusSnapshot copy = latest_;
    const uint32_t after = seq_.load(std::memory_order_acquire);
    if (before == after) {
      return copy;
    }
  }
  StatusSnapshot empty{};
  return empty;
}
