cjlawson02/Rumtime/(commit log)

2026-06-18 Add Rumtime v1 hardware design documentation and contributor guidelines.
    Capture the planned pump architecture, BOM, build plan, and design decisions as the foundation for future firmware, PCB, and software work in this repo.
2026-06-18 Add Phase 0 bench rig assets and lock key v1 decisions.
    Document pump/electronics choices, shopping list, and verification protocol; add ESP32-S3 bring-up firmware and Altium module specs; extend decisions for 16-pump ceiling, labeling, and bottle stoppers.
2026-06-21 Enhance documentation for Rumtime v1, emphasizing load cell requirements and flow-gated dispensing.
    Update AGENTS.md with guidelines for sourcing and part substitutions. Revise README.md to clarify measurement strategy, making load cell usage mandatory. Amend various documentation files to reflect the necessity of load cells for glass detection and flow-gated pour starts, and detail the testing protocols for validation. Ensure all references to load cells are consistent across documentation, reinforcing their critical role in the system's operation.
    [config.h, main.cpp, pump_driver.cpp, pump_driver.h, scale_driver.cpp, scale_driver.h]
2026-06-28 Bench P1/P2 bring-up: session logs, proto=2 serial, and benchctl CLI.
    Capture 2026-06-27 liquid tests (P1+P2 @ 1.75 ml/s, dual ~0.4 A, anti-drip 100 ms, Test 4b ~45/50 ml), fix USB command parsing with a proto=2 line parser, add benchctl.py for reliable host control, and sync docs with measured defaults, procurement issues (24 V pump return, barb mis-ship), project timeline, and Onshape/FDM tooling.
    [benchctl.py, config.h, main.cpp, pump_driver.cpp, serial_parser.cpp, serial_parser.h]
2026-06-28 Add build123d CAD scaffold for bench mechanical parts.
    Lock parametric workflow in hardware/cad with dimension refs, KPHM100 fit
    coupon and mount bracket, load-cell platform plates, export CLI, and optional
    CI; wire docs and gitignore for generated artifacts.
2026-07-04 Lock product firmware runtime model and document ControlTask architecture.
    Add docs/16 with the ESP32 ControlTask, command queue, and transport boundaries;
    update related decisions and system architecture references.
2026-07-04 Add ESP32 controller firmware with ControlTask, coordinator, and Marlin-style serial.
    Product runtime on a 5 ms ControlTask: pump/scale HAL, depth-1 command queue,
    single-pump dispense coordinator, shared command_validate, and enqueue-only
    serial with ok/Error/async job events. Includes 74 native Unity tests.
    [command_queue.cpp, command_queue.h, command_validate.cpp, command_validate.h, config.h, control_task.cpp, control_task.h, coordinator.cpp]
2026-07-04 Add NVS ConfigStore for per-pump calibration and bindings.
    Persist machine config in flash with load-time sanitization, idle commit
    with backoff, and serial cal/bind commands so pours use per-pump rates.
    [command_validate.cpp, command_validate.h, config.h, config_store.cpp, config_store.h, control_task.cpp, control_task.h, coordinator.cpp]
2026-07-04 Harden controller integration layer: queue policy, dispense gates, and host tests.
    Fix cancel→dispense queue flush, add QueueOps seam and atomic cancel, require scale for flow-gated dispense (dispense open override), and add seqlock status plus CRC-guarded NVS v2.
    [command_queue.cpp, command_queue.h, command_validate.cpp, command_validate.h, config.h, config_store.cpp, config_store.h, control_task.cpp]
2026-07-05 Document locked kiosk UX and provisional device HTTP API contract.
2026-07-05 Add production kiosk PWA with menu, pour, setup flows, and CI.
    Introduces the React + Vite touch UI at ui/kiosk with mock/HTTP device clients, operator wizards, Vitest coverage, and a GitHub Actions workflow; updates docs and README to point at the new app and provisional device API contract.
2026-07-06 Add sequence runner, Wi-Fi HTTP, and inventory for kiosk device API.
    Implements multi-step recipe pours, LAN HTTP matching the kiosk contract,
    inventory/primed gating, cross-task config routing, and 175 native tests so
    the Kindle can talk to the ESP32 without MSW.
2026-07-06 Enhance MockDeviceClient with inventory validation and error handling improvements.
    - Added inventory validation to ensure sufficient stock before pouring.
    - Updated error handling to return 422 status for various conditions (e.g., low inventory, unassigned pumps).
    - Refactored tests to cover new inventory checks and error scenarios.
    - Adjusted mock device configuration to reflect changes in pump count and job handling.
2026-07-06 Fix pour/cancel races, NVS commits, and kiosk status handling.
    Drop deferred cutoff-sense firmware in favor of main-power safety, harden coordinator cancel/flow-wait and combined config+inventory NVS writes, and fix kiosk pour lifecycle, menu stale-data, and swap rollback bugs.
    [command_queue.cpp, command_queue.h, command_validate.cpp, command_validate.h, config.h, config_store.cpp, config_store.h, control_task.cpp]
2026-07-06 Consolidate controller preflight validation and NVS CRC helpers.
    Reduce duplicated snapshot/store paths, shared inventory reserve checks, and redundant sequence drain validation while simplifying config-op queue and persist error state.
    [command_queue.h, command_validate.cpp, config_op_queue.cpp, config_op_queue.h, config_store.cpp, control_task.cpp, control_task.h, crc32.h]
2026-07-06 Fix controller CI by removing dead NvsOps commit hook.
    Arduino Preferences persists on putBytes, so the commit callback was always a no-op and broke the ESP32 build. Apply clang-format and include Arduino.h for scale_platform millis().
    [command_queue.cpp, command_validate.cpp, config_store.cpp, config_store.h, control_task.cpp, http_server.cpp, inventory_store.cpp, machine_store_commit.cpp]
2026-07-11 Upgrade kiosk npm deps and adopt TypeScript 6/7 side-by-side aliases.
    Bump dev and runtime packages to current releases while keeping typescript-eslint on TS 6 and routing tsc through TS 7 for faster typecheck builds.
2026-07-12 Fix kiosk lint and lock in TypeScript 6/7 side-by-side tooling.
    Clear strict ESLint failures, pin Node 24, restore the typescript6 alias so eslint keeps a TS 6 API, and typecheck with native TS 7 (plus a TS 6 stableTypeOrdering smoke script).
2026-07-13 Harden pour cancel and Wi-Fi disconnect stop for bench validation.
    Fix kiosk pour lifecycle/progress and controller link safety so cancel and STA drop stop pumps cleanly; log session 03 (open-loop happy path, no scale).
    [command_queue.cpp, command_queue.h, command_validate.cpp, config.h, control_task.cpp, control_task.h, controllerctl.py, coordinator.cpp]
2026-10-19 Upgrade kiosk npm deps and adapt to MSW 3 / React Query APIs.
    Bump packages to latest, regenerate the MSW worker, switch fetchQuery to query, and reformat for the newer Prettier so UI CI stays green.
2026-10-19 Fix firmware clang-format and add path-filtered pre-commit CI hooks.
    Match CI formatting, unblock native tests missing string include, and run clang-format plus firmware/ui checks on staged paths before commit.
2026-10-26 Track the KiCad projects so the 4-pump board can be restored from git.
2026-10-30 Lock in both PCBs for fab and sync hardware, firmware pins, and procurement.
    4-pump and main-controller KiCad layouts are ordered; motherboard GPIO map, CAD refs, bench logs, and AliExpress/OSH Park procurement notes are brought current so assembly can proceed when boards arrive.
2026-11-02 Log Nov 1 parts receive and motor JST harness.
    Oct 25 AliExpress module/motherboard batches are on hand; note Oct 29 remainder and PCBs still out.
2026-11-02 Draft rear-bay enclosure concept with slot rails, blind-mate dock, and rear panel.
    Mockup is a draft: build123d model and SVG renderer, final module/controller PCB refs, SW1 rocker and 12 V inlet plug refs, and Test 11 enclosure bench checks. Unvalidated until Test 11 passes.
2026-11-09 Track open OTA firmware-update task for ESP32-S3.
    Document the planned dual-app partition + idle HTTP upload approach (not ESPHome's native protocol), with rollback/hardening and effort notes.
2026-11-09 Land recipe phases with a six-pump concurrency cap, plus glass-gated pours and ring light.
    Config-driven phases and B-52 layered shots land end-to-end; recipe pours require scale mass ≥50g (no_glass) and GPIO 13 tracks glass presence.
2026-11-09 Switch firmware platforms to official espressif32 8.0.0.
    Drop the pioarduino 55.03.39 URL pin now that PlatformIO ships Arduino-ESP32 3.3.x.
2026-11-09 Add spirit shot catalog with local drink photos and tighten MSW mock setup.
    Ship five 45 ml shots plus a B-52 photo, document free-license attribution, and make Vite mock-device defaults clearer for rumtime.local development.
